AmigaPCI/AmigaPCI-LBC040/KiCAD/AmigaPCI-LBC040-REV60/AmigaPCI-Footprints/PCIe-x16.step

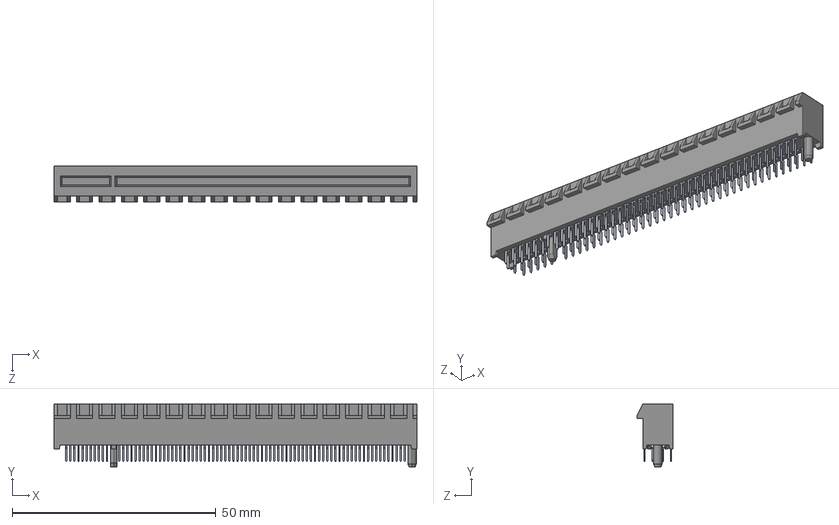
[picture p1: CAD file, 2026-06-23]
KiCAD/AmigaPCI-LBC040-REV60/AmigaPCI-Footprints/PCIe-x16.step
89.0 x 15.4 x 8.80 mm
