AmigaPCI/AmigaPCI-LBC040/KiCAD/AmigaPCI-LBC040-REV60/AmigaPCI-Footprints/DIN150_MALE.STEP

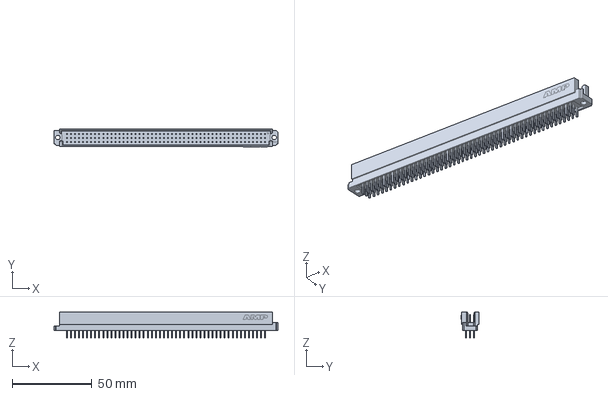
[picture p2: CAD file, 2026-06-23]
KiCAD/AmigaPCI-LBC040-REV60/AmigaPCI-Footprints/DIN150_MALE.STEP
140.6 x 11.0 x 16.1 mm
