AmigaPCI/AmigaPCI-LBC040/KiCAD/AmigaPCI-LBC040-REV60/AmigaPCI-Footprints/5145154-4.step

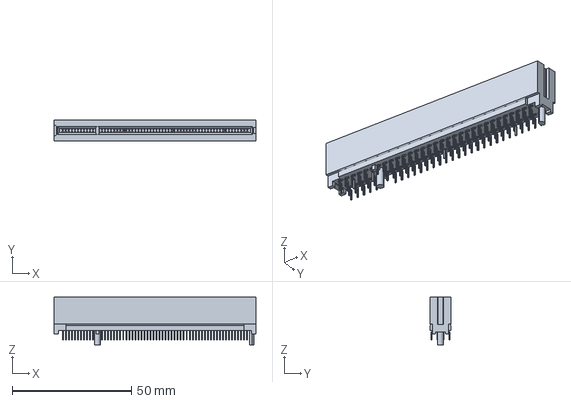
[picture p3: CAD file, 2026-06-23]
KiCAD/AmigaPCI-LBC040-REV60/AmigaPCI-Footprints/5145154-4.step
84.8 x 8.89 x 20.1 mm
