AmigaPCI/AmigaPCI-LBC040/KiCAD/AmigaPCI-LBC040-REV60/AmigaPCI-Footprints/5650910-5.stp

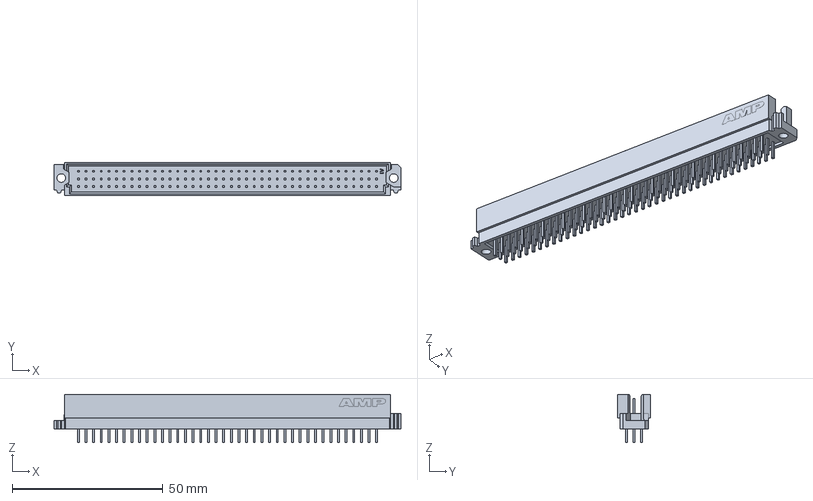
[picture p4: CAD file, 2026-06-23]
KiCAD/AmigaPCI-LBC040-REV60/AmigaPCI-Footprints/5650910-5.stp
115.2 x 11.0 x 16.1 mm
