AmigaPCI/AmigaPCI-LBC040/Schematic/AmigaPCI 68040 Local Bus Card REV60.pdf

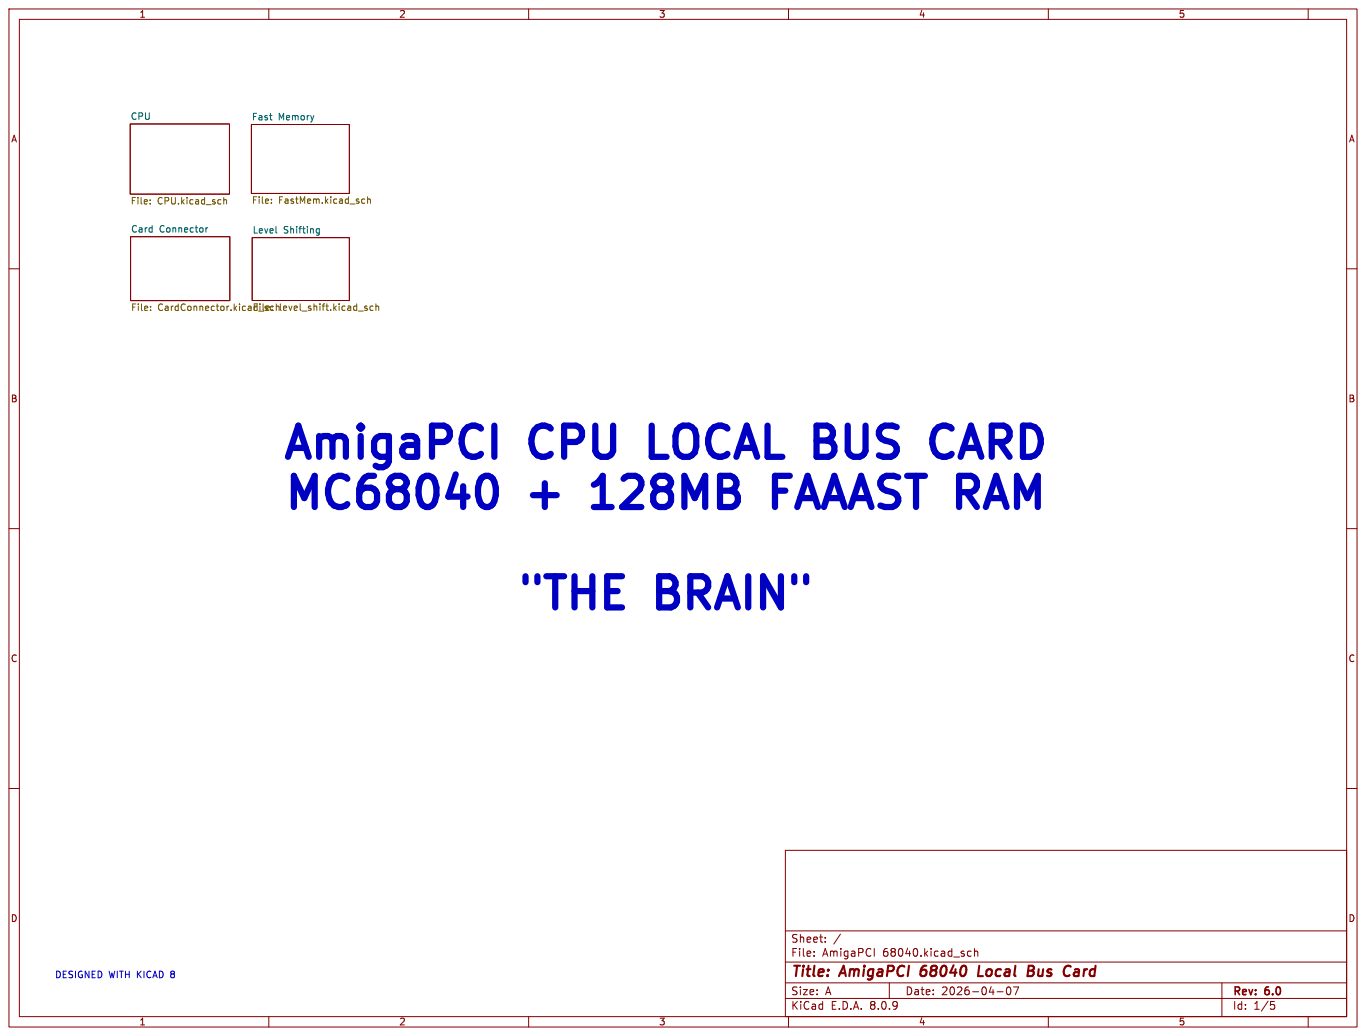
[picture p5: page 1]

Id: 1/5 Title: AmigaPCI 68040 Local Bus Card

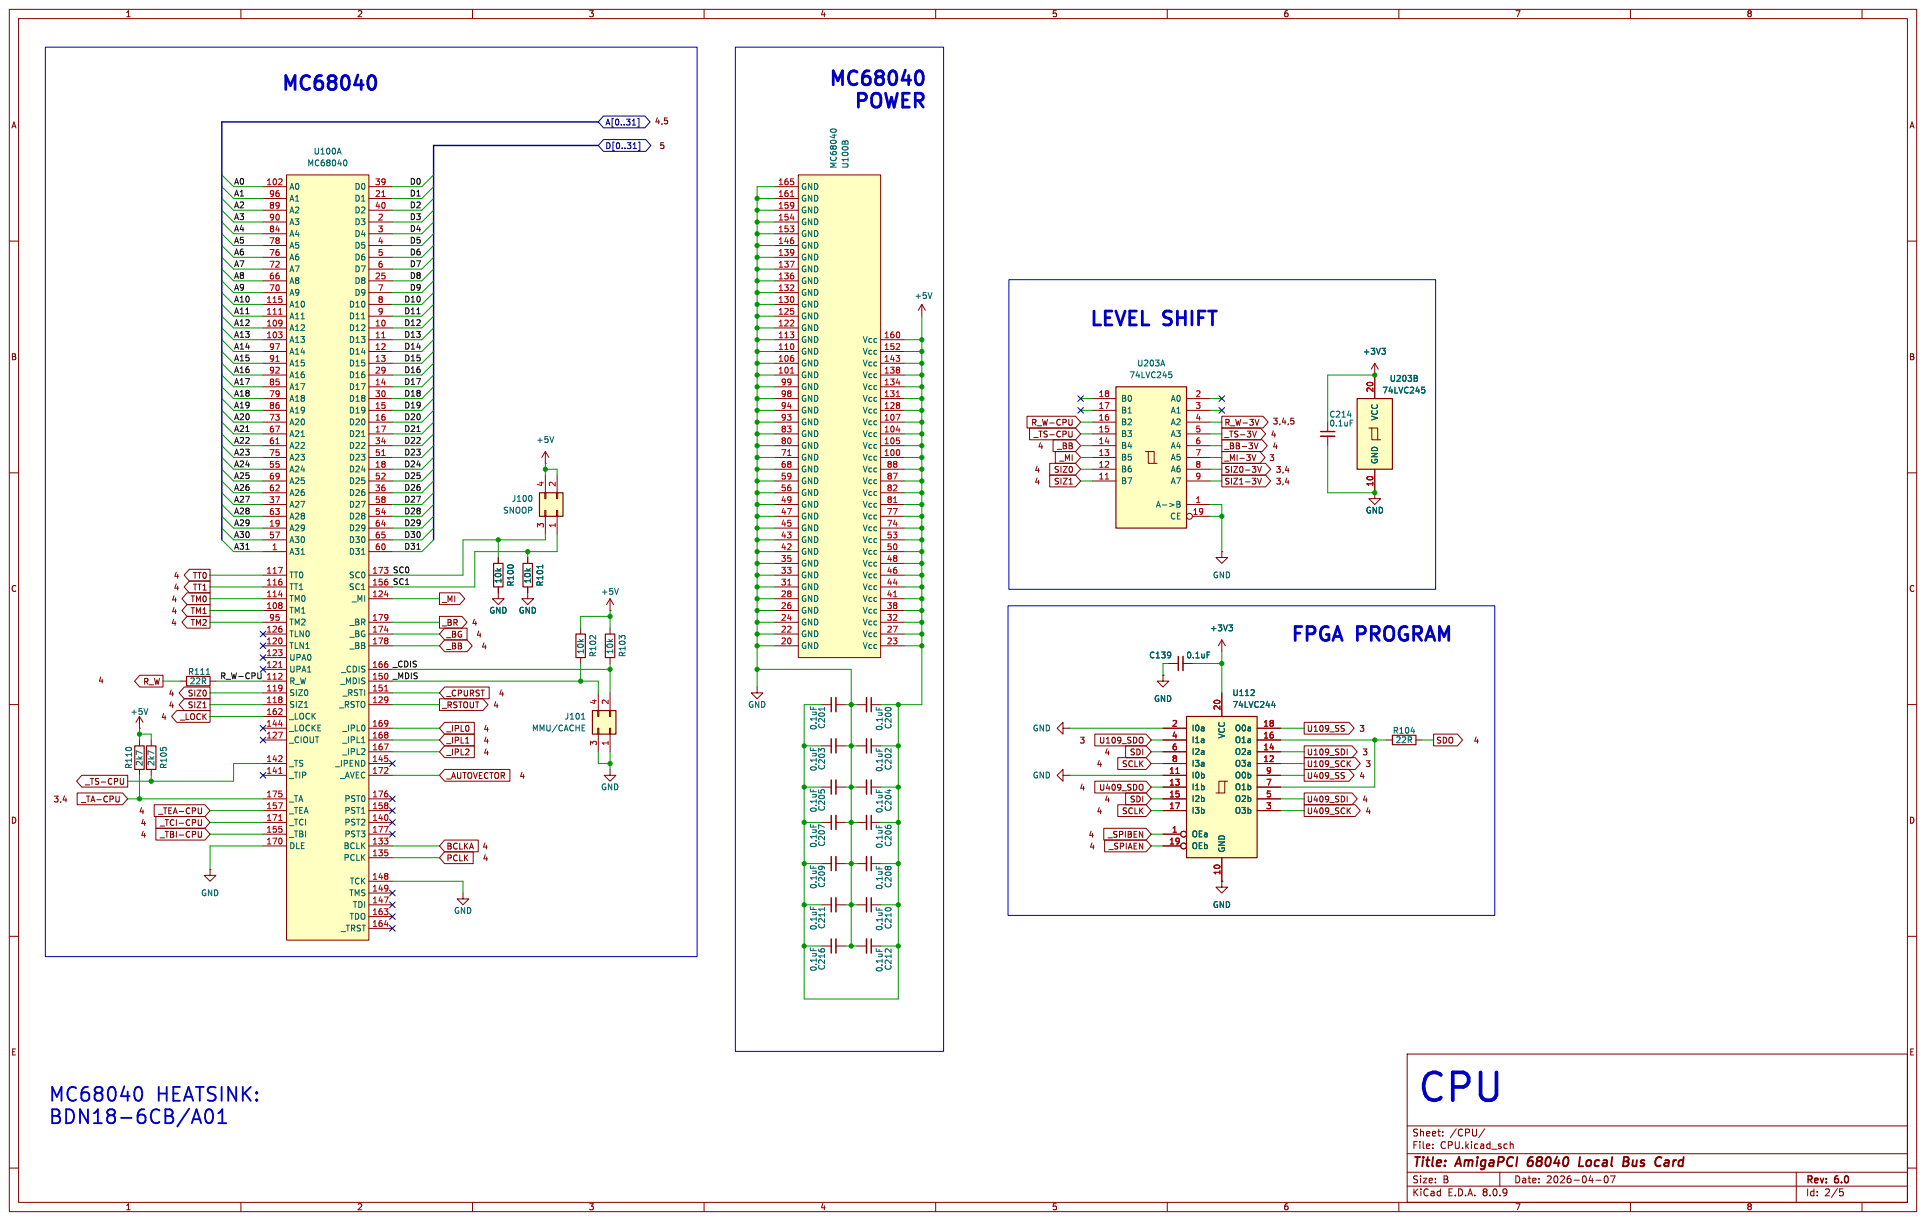
[picture p6: page 2]

74LVC245 GND 10 VCC 20 +3V3 GND GND

Id: 2/5 Title: AmigaPCI 68040 Local Bus Card

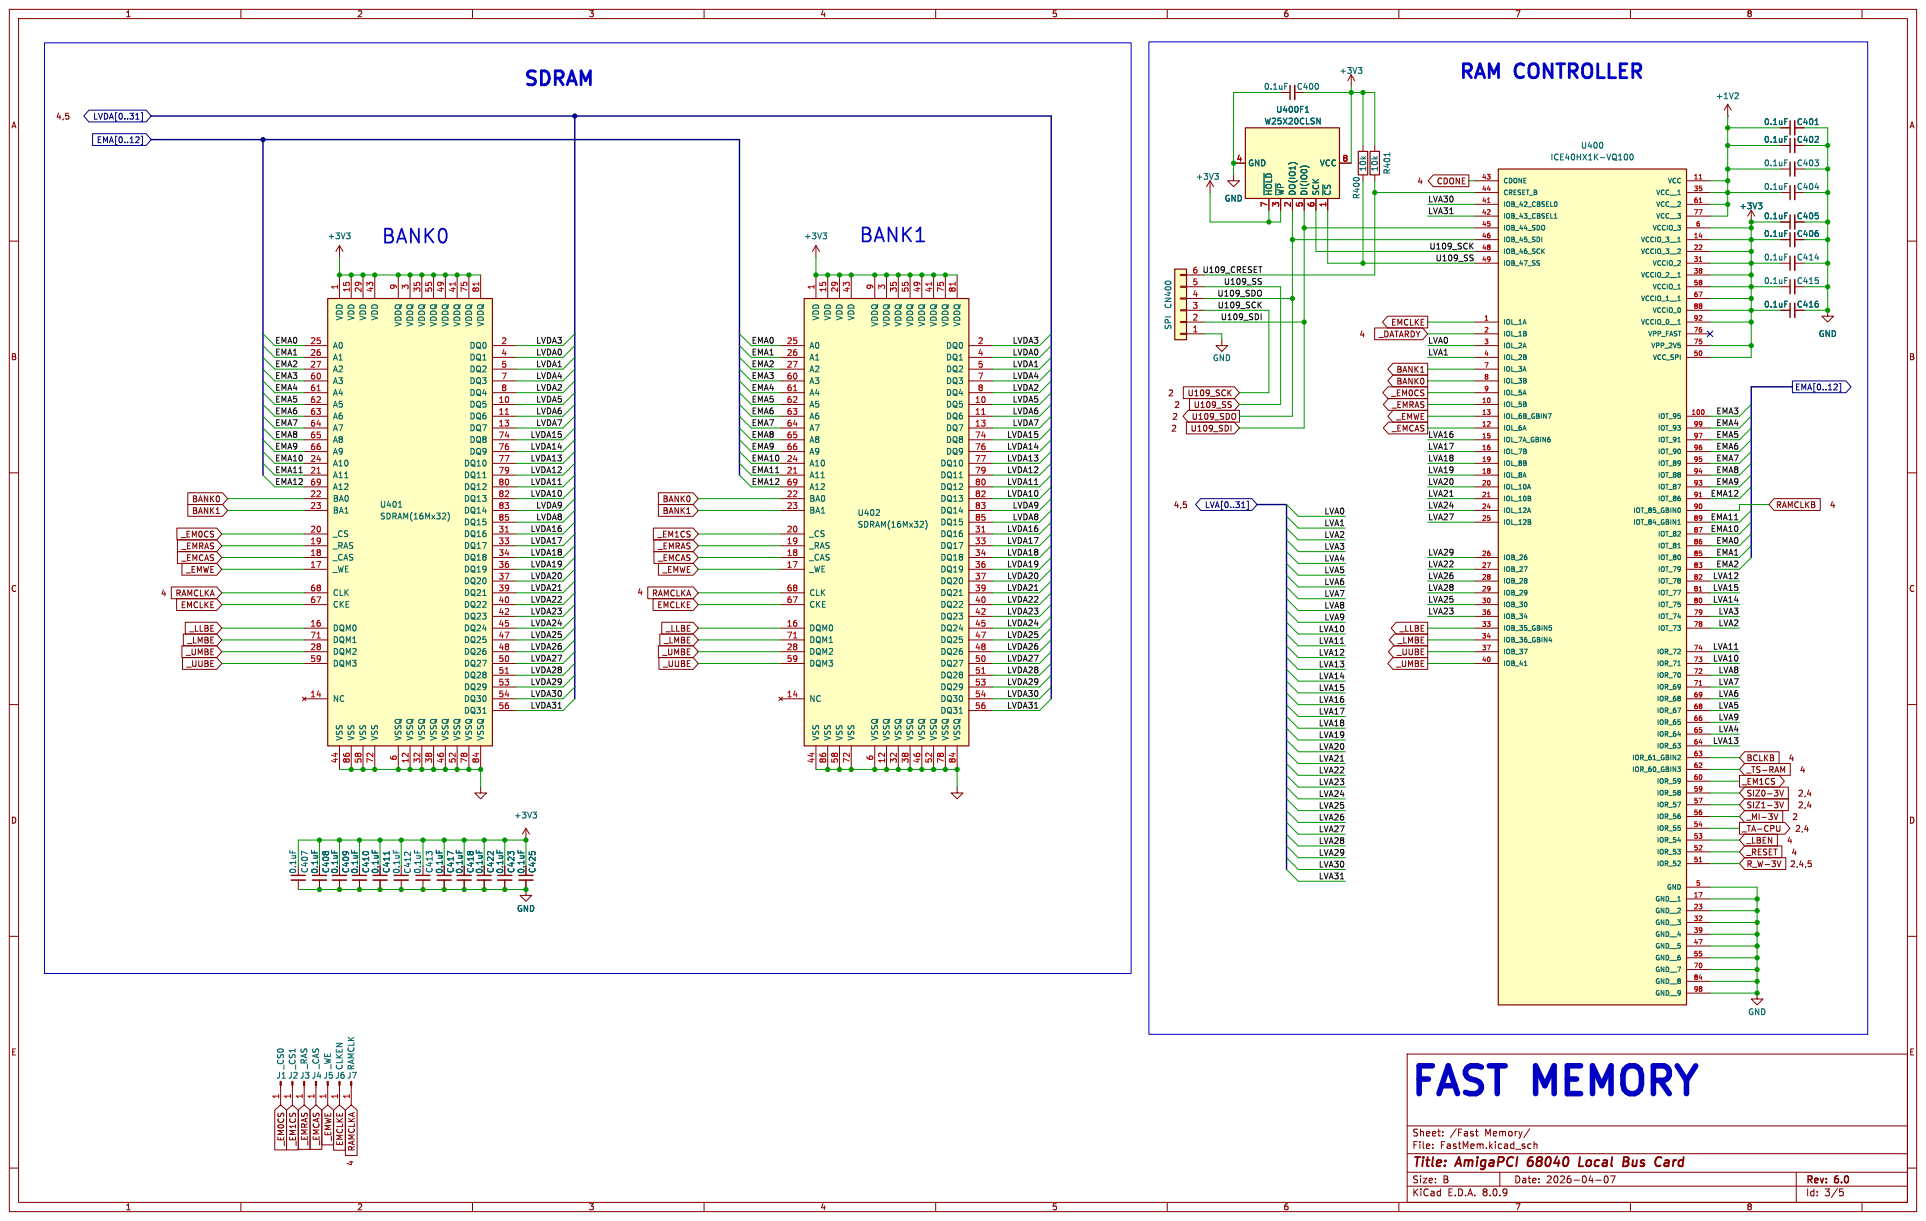
[picture p7: page 3]

Id: 3/5 Title: AmigaPCI 68040 Local Bus Card

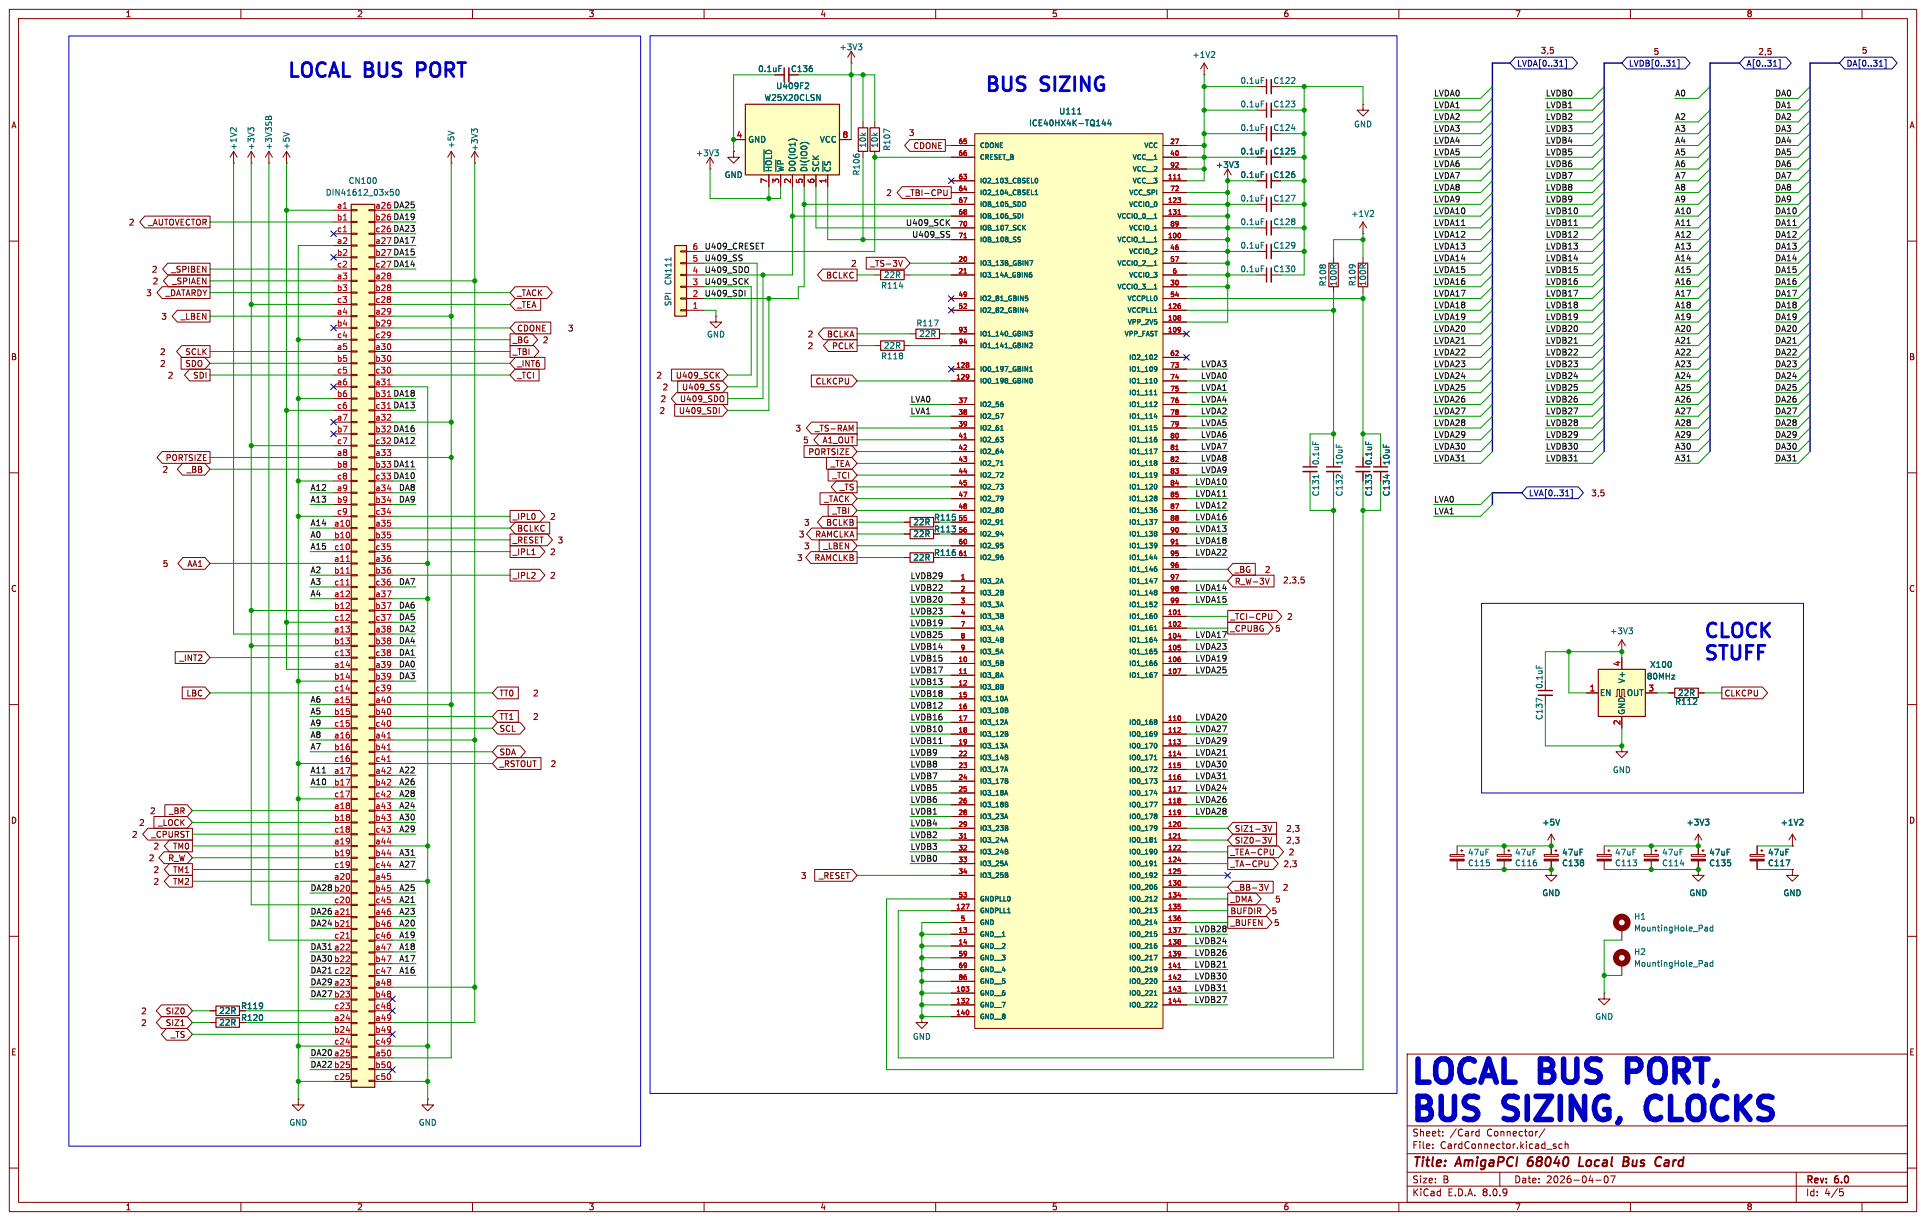
[picture p8: page 4]

Id: 4/5 Title: AmigaPCI 68040 Local Bus Card

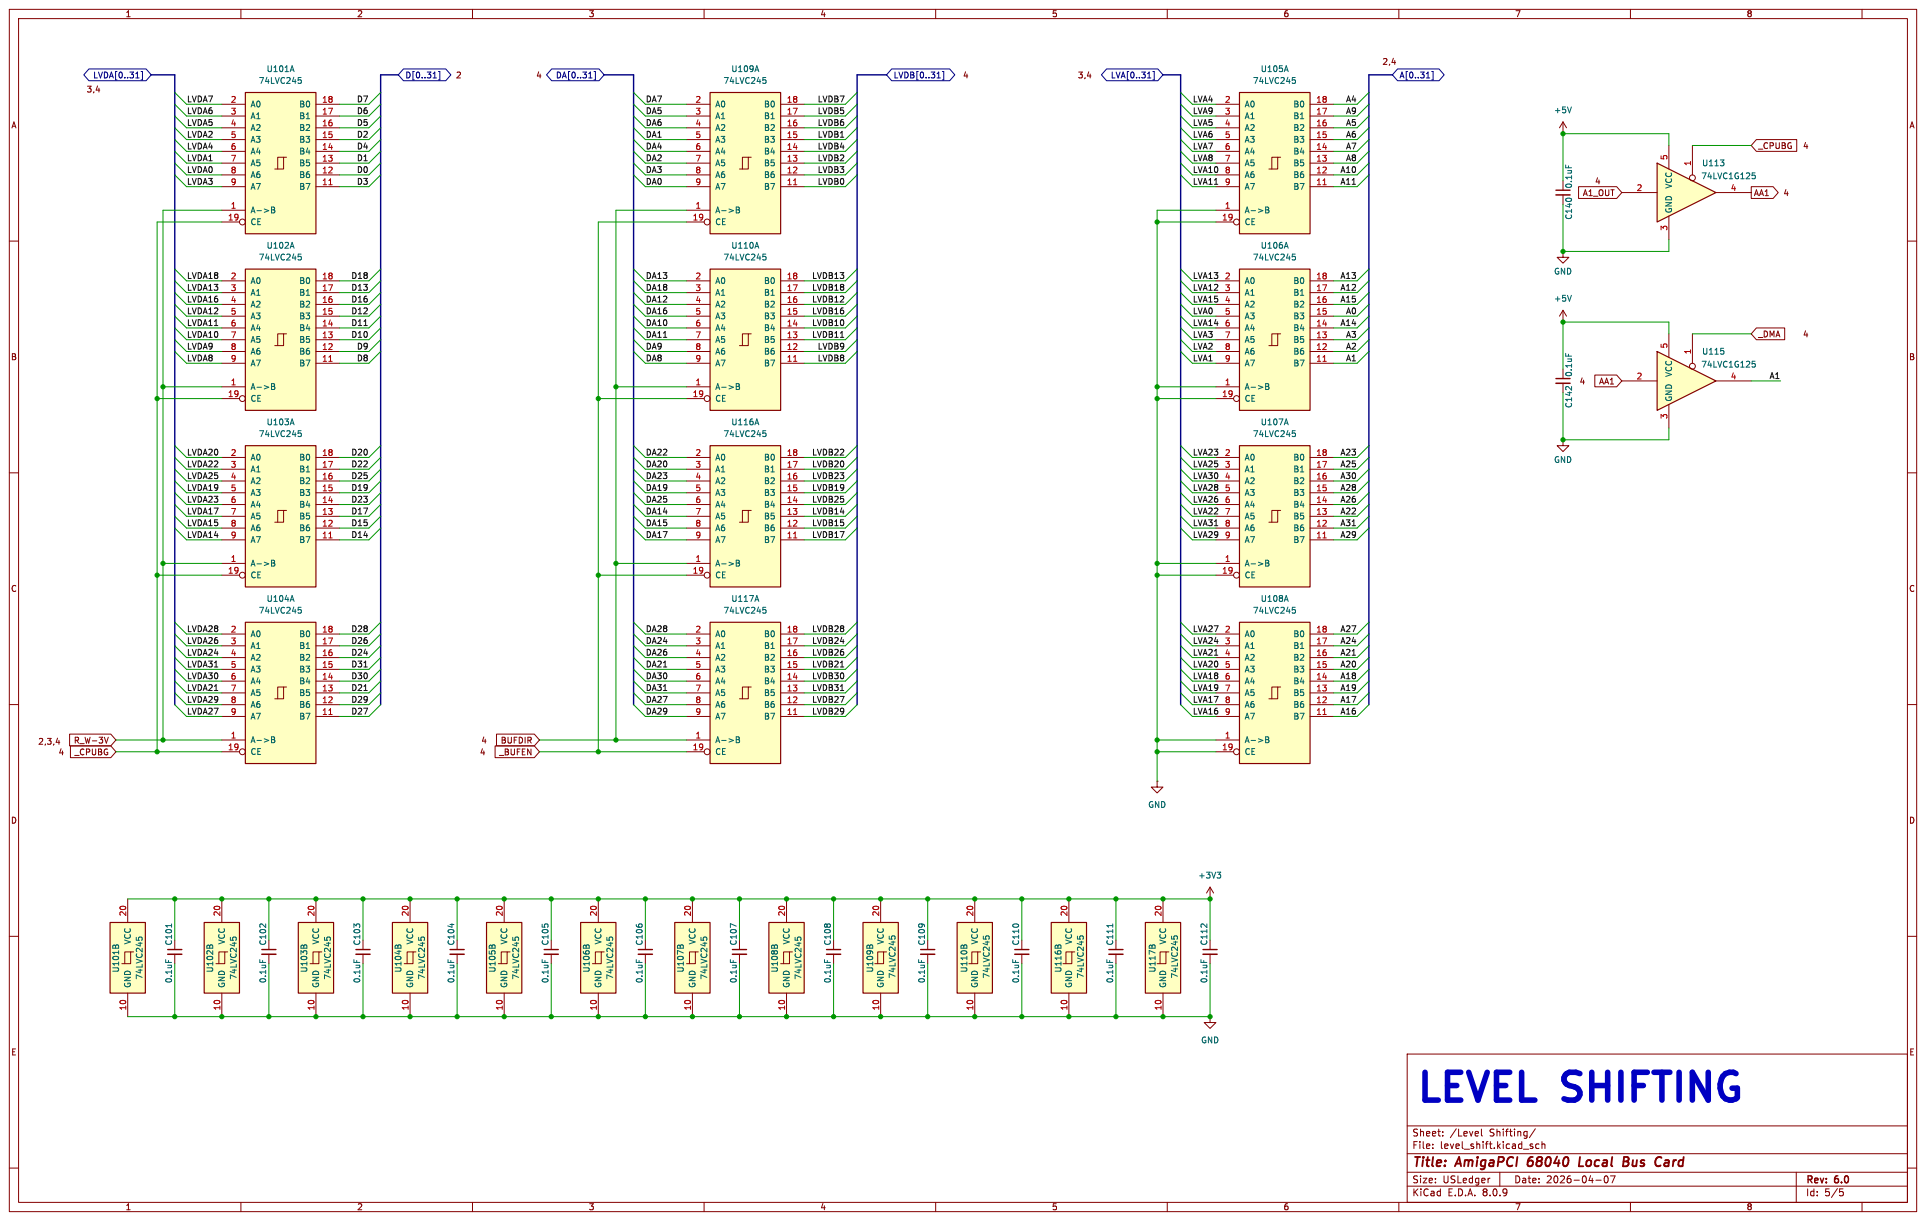
[picture p9: page 5]

Id: 5/5 Title: AmigaPCI 68040 Local Bus Card
