AmigaPCI/AmigaPCI-LBC040/KiCAD/AmigaPCI-LBC040-REV60/AmigaPCI 68040.kicad_pcb

## KiCad design KiCAD/AmigaPCI-LBC040-REV60/AmigaPCI 68040.kicad_pcb (2026-06-23)

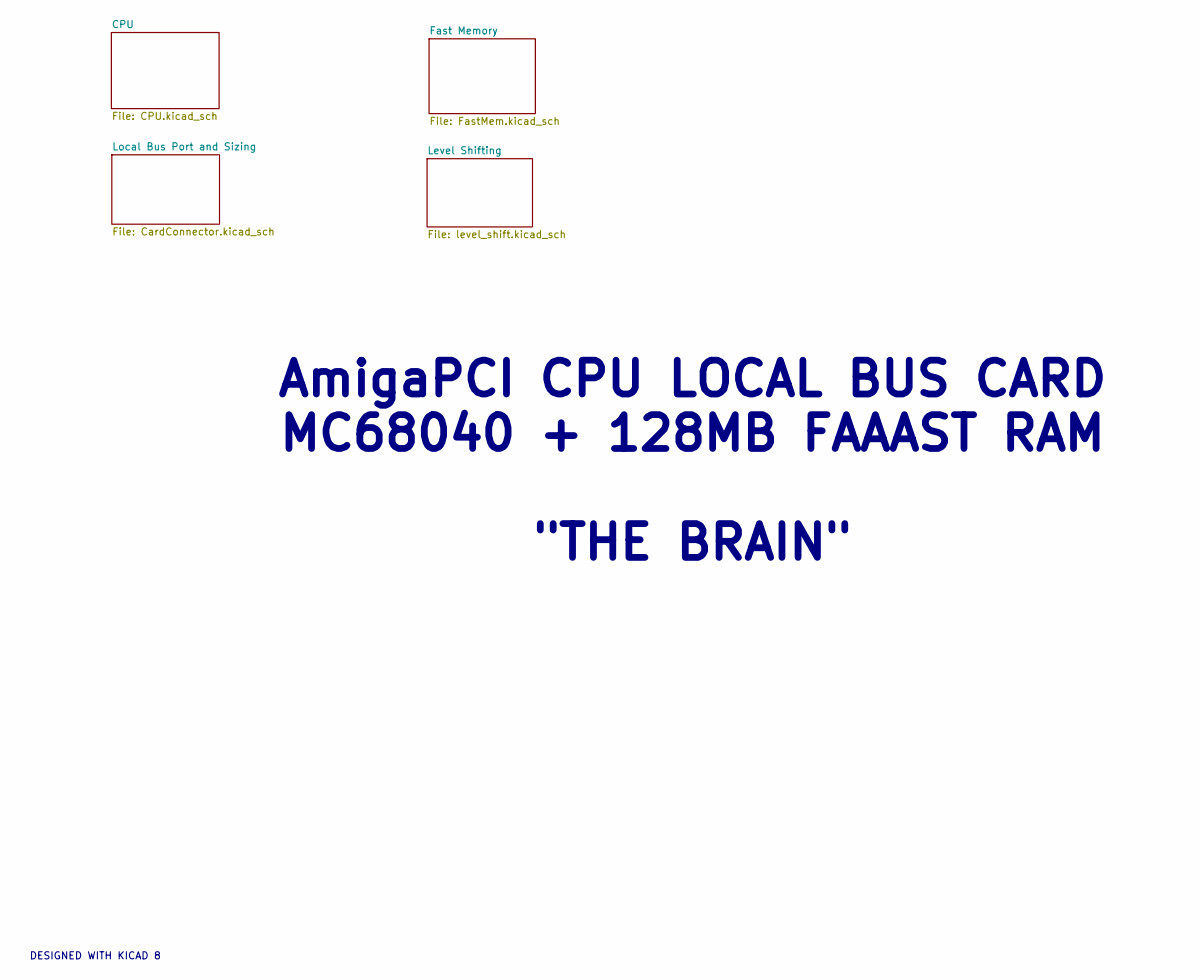
[picture p10: schematic AmigaPCI 68040.kicad_sch, AmigaPCI 68040 Local Bus Card]

Notes on the sheet:
DESIGNED WITH KICAD 8
AmigaPCI CPU LOCAL BUS CARD MC68040 + 128MB FAAAST RAM "THE BRAIN"

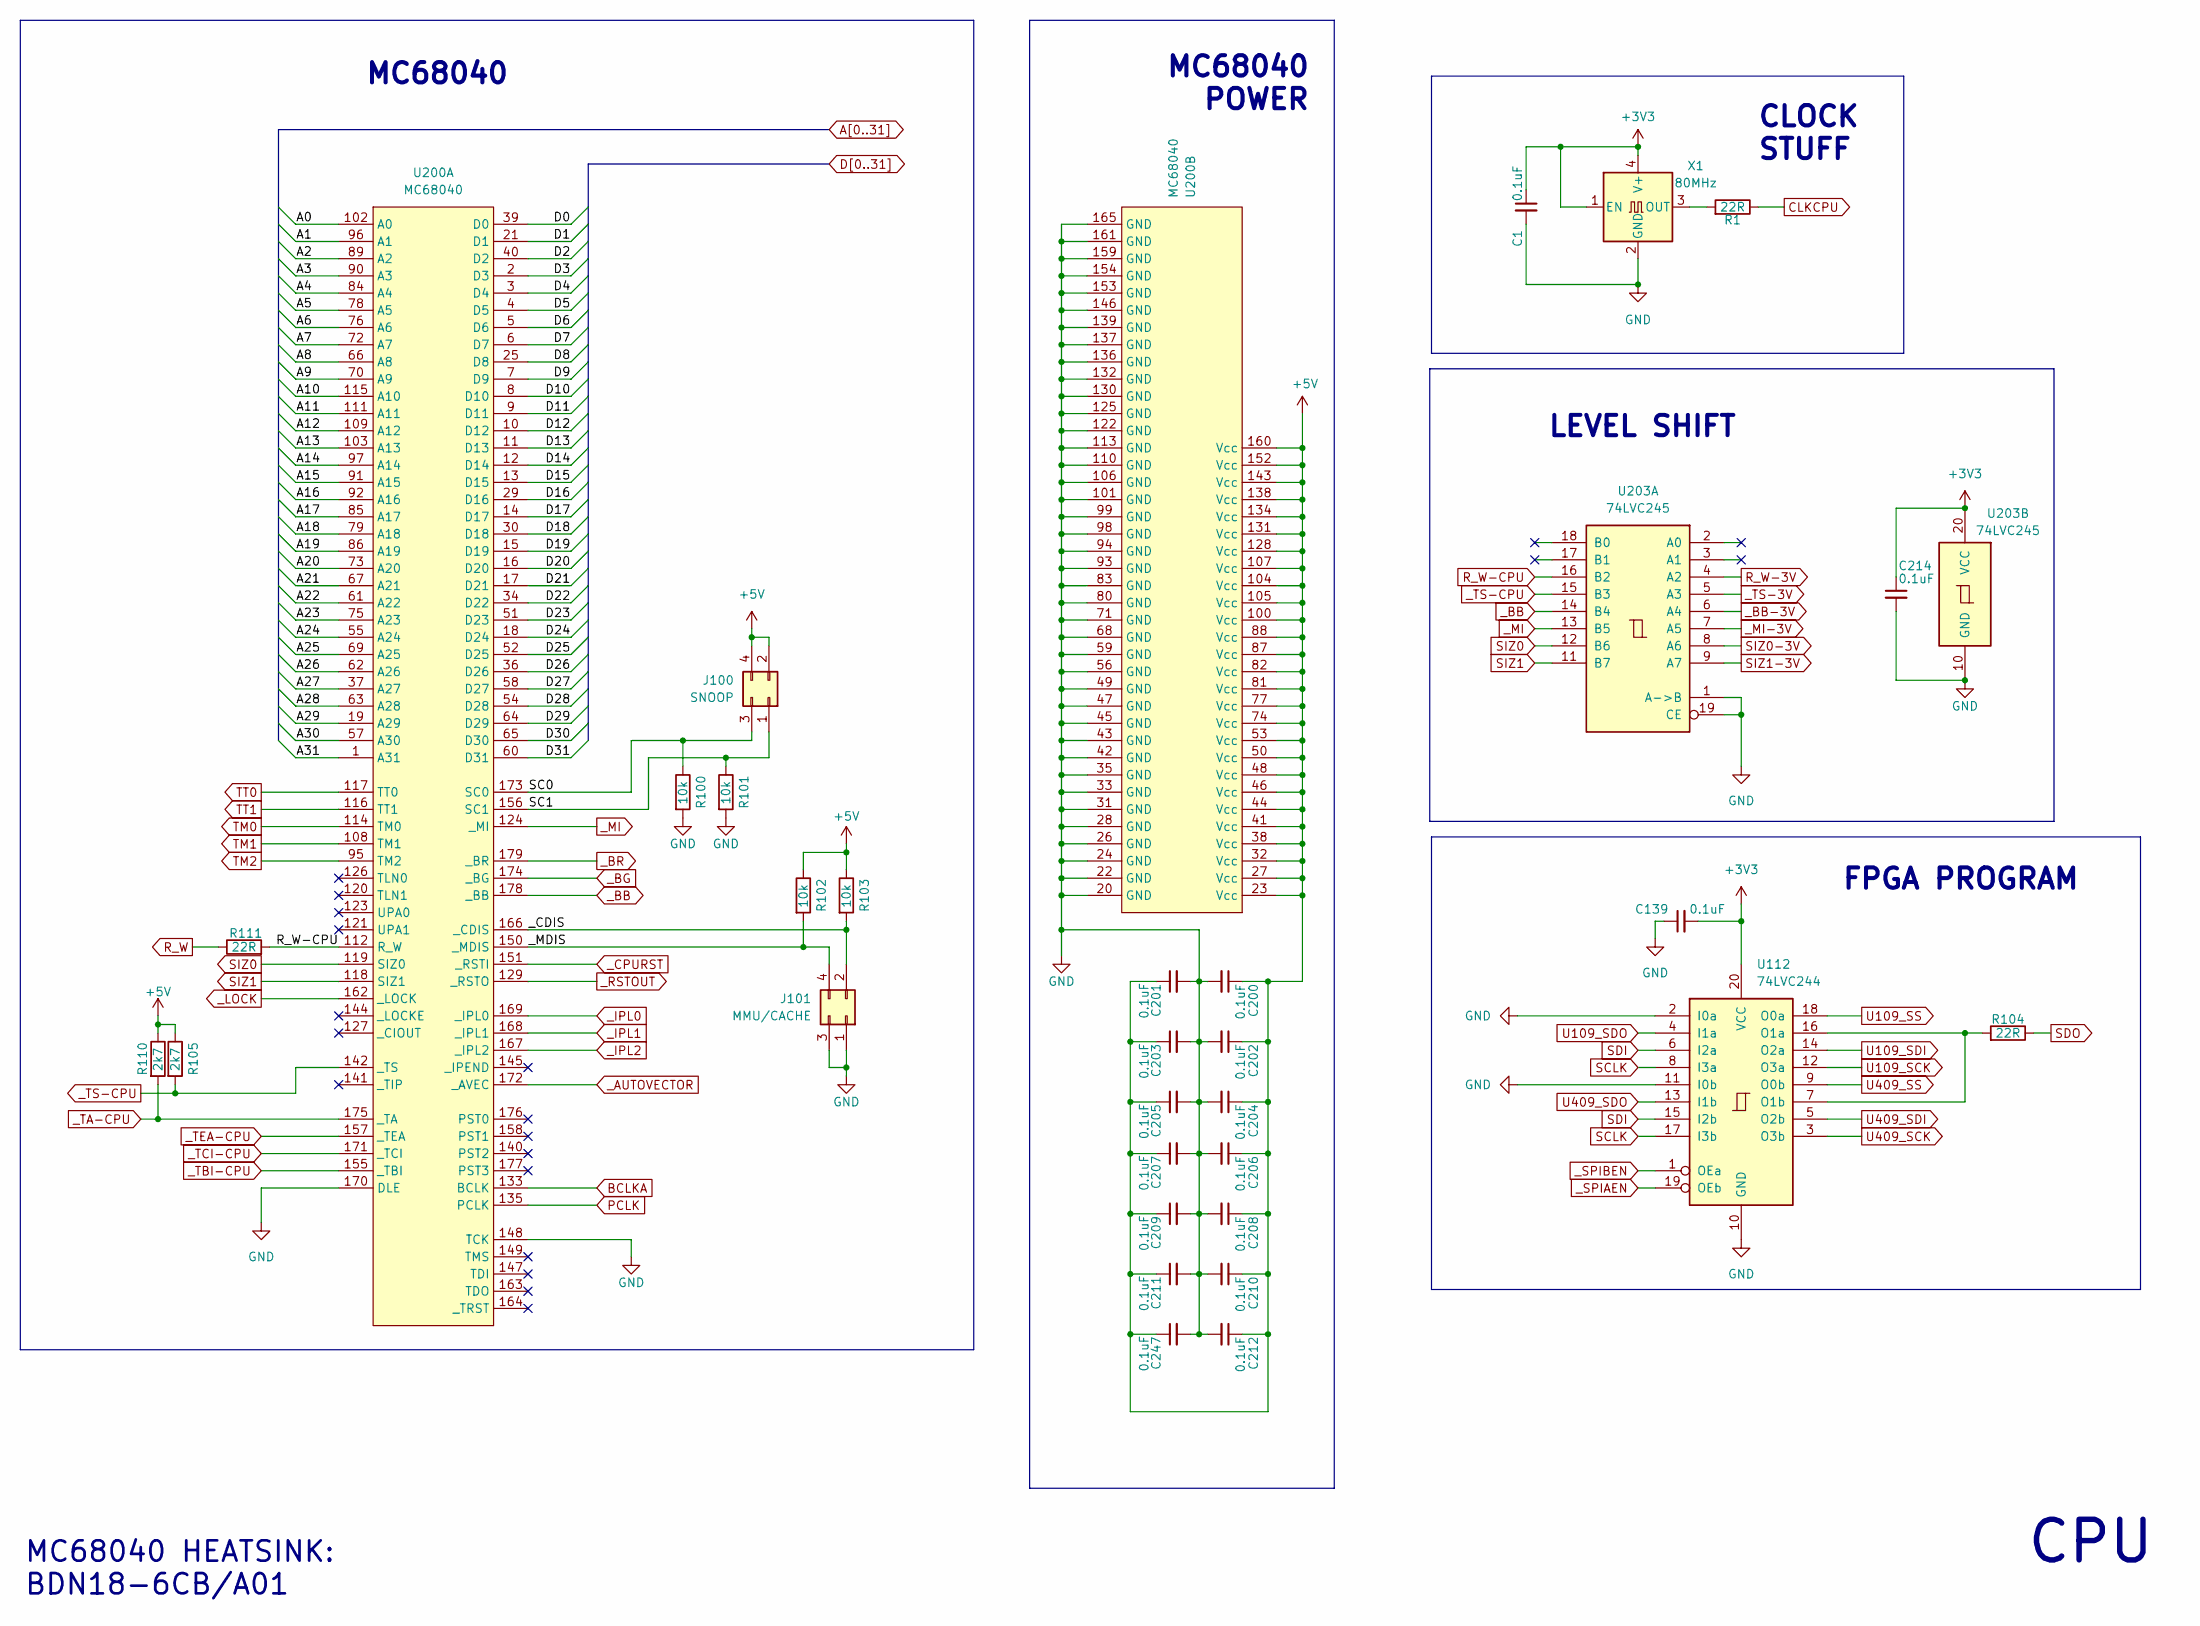
[picture p11: schematic CPU.kicad_sch, AmigaPCI 68040 Local Bus Card]

Parts:
C1, C139, C200, C201, C202, C203, C204, C205, C206, C207, C208, C209, C210, C211, C212, C214, C247: 0.1uF; C_0603_1608Metric; LCSC C14663
J100: SNOOP; PinHeader_2x02_P2.54mm_Vertical; LCSC C66690
J101: MMU/CACHE; PinHeader_2x02_P2.54mm_Vertical; LCSC C66690
R1, R104, R111: 22R; R_0603_1608Metric; LCSC C23345
R100, R101, R102, R103: 10k; R_0603_1608Metric; LCSC C25804
R105, R110: 2k7; R_0603_1608Metric; LCSC C13167
U112: 74LVC244; TSSOP-20_4.4x6.5mm_P0.65mm; LCSC C7668
U200: MC68040; PGA179
U203: 74LVC245; TSSOP-20_4.4x6.5mm_P0.65mm; LCSC C7848
X1: 80MHz; Oscillator_SMD_ECS_2520MV-xxx-xx-4Pin_2.5x2.0mm; LCSC C557215

Connections:
+3V3: C1.1, C139.2, C214.1, U112.20 (VCC), U203.20 (VCC), X1.1 (EN), X1.4 (V+); also elsewhere on the board
+5V: C200.1, C201.1, C202.1, C203.1, C204.1, C205.1, C206.1, C207.1, C208.1, C209.1, C210.1, C211.1, C212.1, J100.2, J100.4, R102.1, R103.1, R105.1, R110.1; also elsewhere on the board
/CPU/SC0: J100.3, R100.1; also elsewhere on the board
/CPU/SC1: J100.1, R101.1; also elsewhere on the board
/CPU/_CDIS: J101.2, R103.2; also elsewhere on the board
/CPU/_MDIS: J101.4, R102.2; also elsewhere on the board
GND: C1.2, C139.1, C200.2, C201.2, C202.2, C203.2, C204.2, C205.2, C206.2, C207.2, C208.2, C209.2, C210.2, C211.2, C212.2, C214.2, J101.1, J101.3, R100.2, R101.2, U112.2 (I0a), U112.10 (GND), U112.11 (I0b), U203.1 (A->B), U203.10 (GND), U203.19 (CE), X1.2 (GND); also elsewhere on the board
unnamed: R1.2, X1.3 (OUT)
unnamed: R104.2, U112.7 (O1b), U112.16 (O1a)
R_W: R111.1; also elsewhere on the board
R_W-3V: U203.4 (A2); also elsewhere on the board
R_W-CPU: R111.2, U203.16 (B2); also elsewhere on the board
SCLK: U112.8 (I3a), U112.17 (I3b); also elsewhere on the board
SDI: U112.6 (I2a), U112.15 (I2b); also elsewhere on the board
SDO: R104.1; also elsewhere on the board
SIZ0: U203.12 (B6); also elsewhere on the board
SIZ0-3V: U203.8 (A6); also elsewhere on the board
SIZ1: U203.11 (B7); also elsewhere on the board
SIZ1-3V: U203.9 (A7); also elsewhere on the board
U109_SCK: U112.12 (O3a); also elsewhere on the board
U109_SDI: U112.14 (O2a); also elsewhere on the board
U109_SDO: U112.4 (I1a); also elsewhere on the board
U109_SS: U112.18 (O0a); also elsewhere on the board
U409_SCK: U112.3 (O3b); also elsewhere on the board
U409_SDI: U112.5 (O2b); also elsewhere on the board
U409_SDO: U112.13 (I1b); also elsewhere on the board
U409_SS: U112.9 (O0b); also elsewhere on the board
_BB: U203.14 (B4); also elsewhere on the board
_BB-3V: U203.6 (A4); also elsewhere on the board
_MI: U203.13 (B5); also elsewhere on the board
_MI-3V: U203.7 (A5); also elsewhere on the board
_SPIAEN: U112.19 (OEb); also elsewhere on the board
_SPIBEN: U112.1 (OEa); also elsewhere on the board
_TA-CPU: R110.2; also elsewhere on the board
_TS-3V: U203.5 (A3); also elsewhere on the board
_TS-CPU: R105.2, U203.15 (B3); also elsewhere on the board

Notes on the sheet:
FPGA PROGRAM
MC68040 HEATSINK: BDN18-6CB/A01
LEVEL SHIFT
MC68040
CLOCK STUFF
MC68040 POWER
CPU

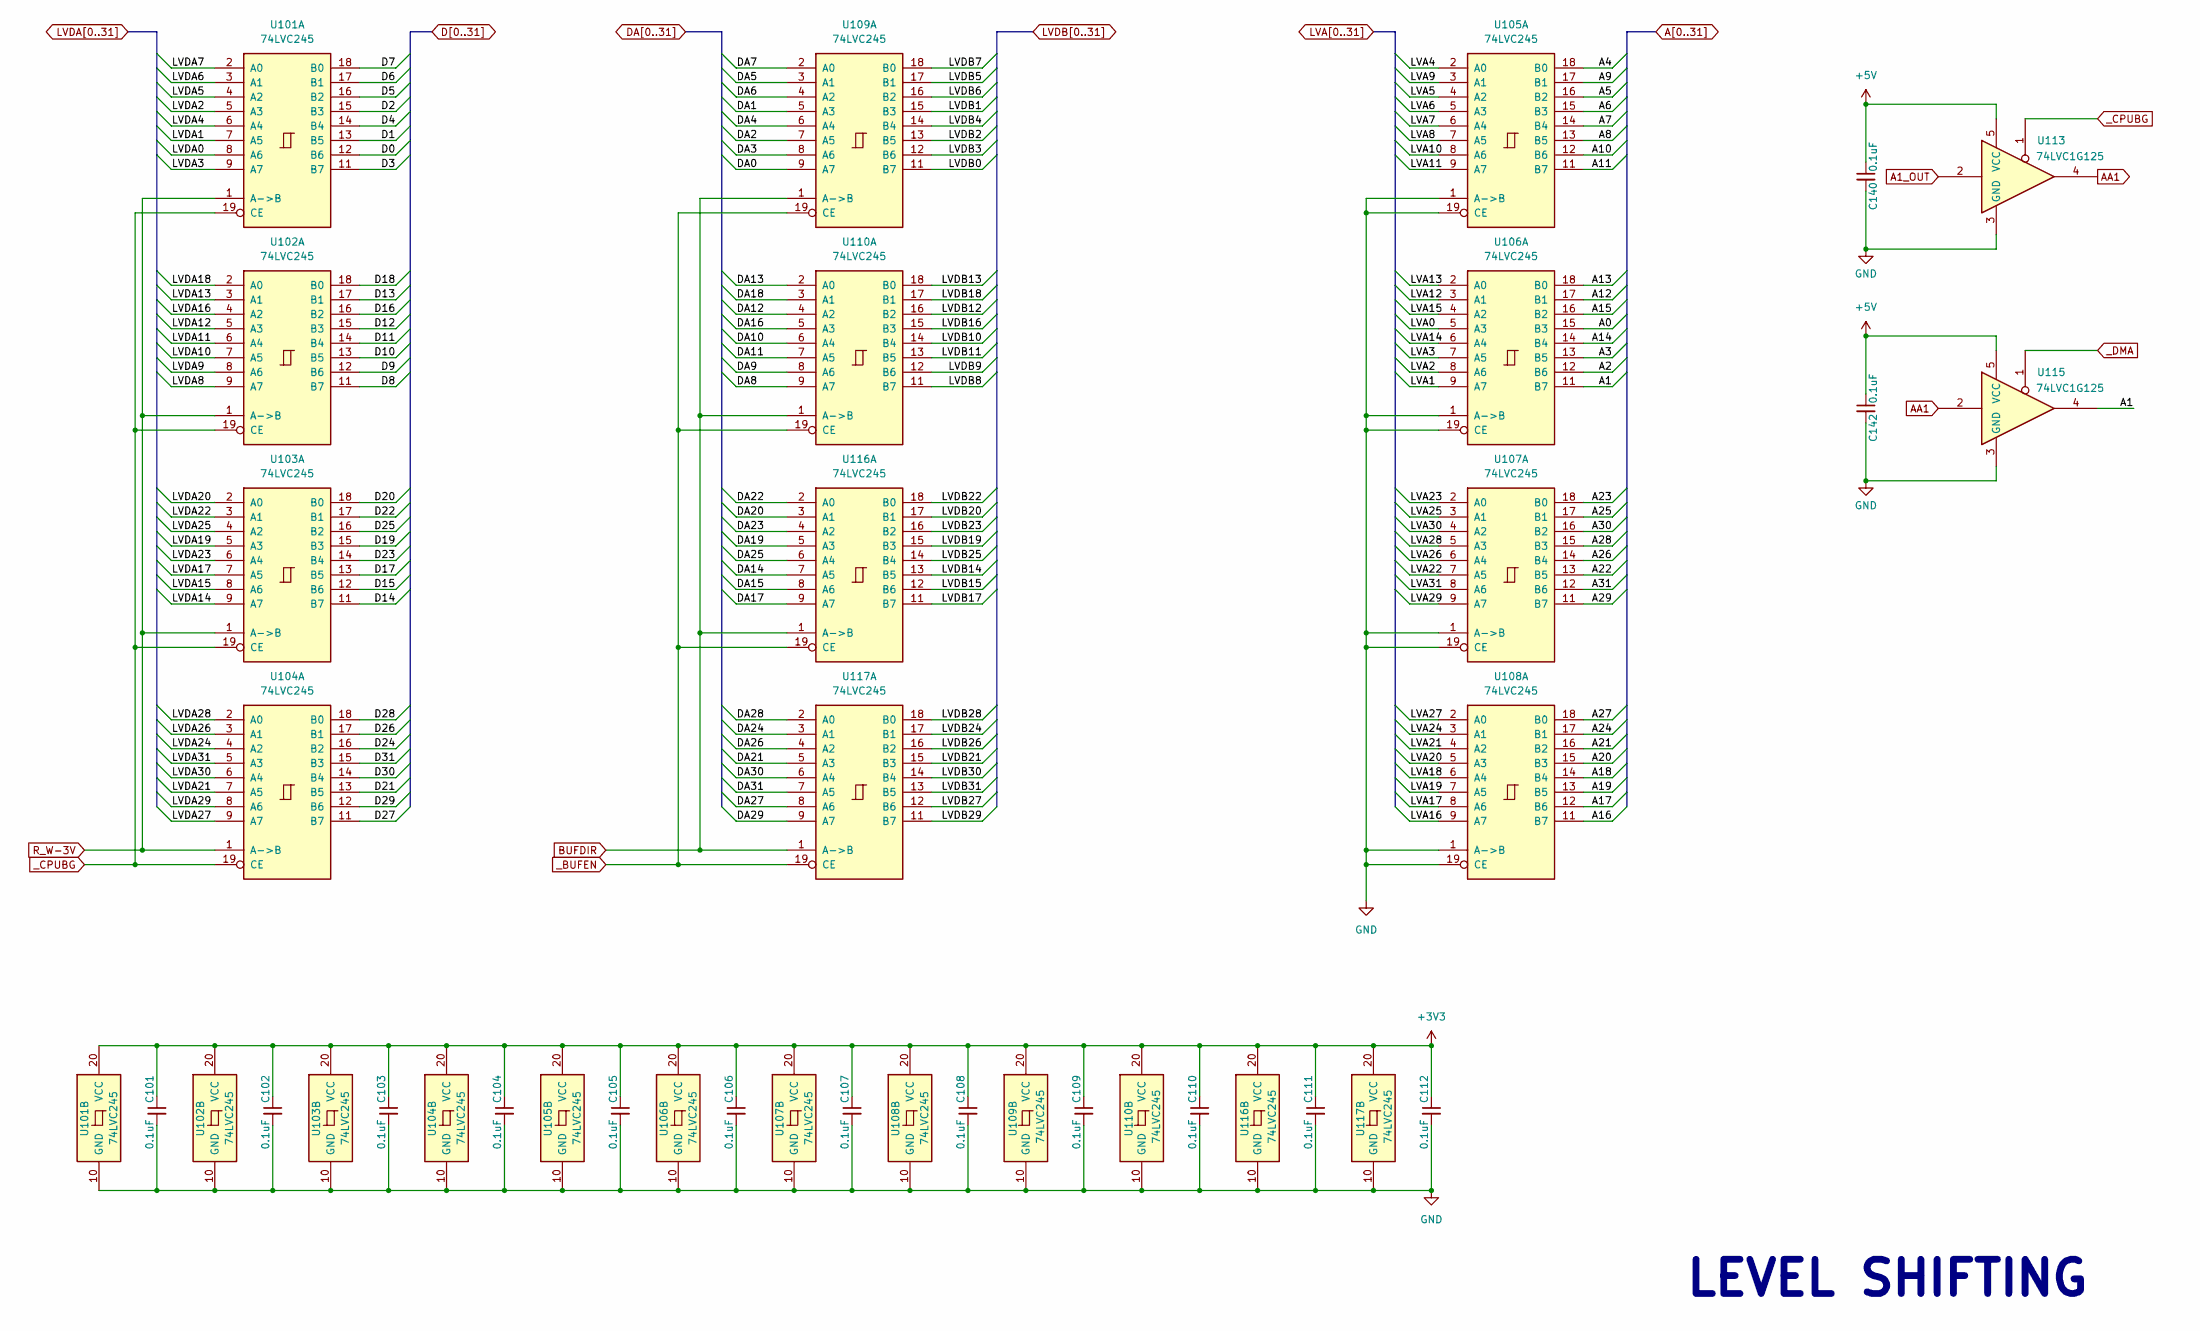
[picture p12: schematic level_shift.kicad_sch, AmigaPCI 68040 Local Bus Card]

Parts:
C101, C102, C103, C104, C105, C106, C107, C108, C109, C110, C111, C112, C140, C142: 0.1uF; C_0603_1608Metric; LCSC C14663
U101, U102, U103, U104, U105, U106, U107, U108, U109, U110, U116, U117: 74LVC245; TSSOP-20_4.4x6.5mm_P0.65mm; LCSC C7848
U113, U115: 74LVC1G125; SOT-353_SC-70-5; PartNum SN74LVC1G125DBVR; LCSC C151022

Connections:
+3V3: C101.1, C102.1, C103.1, C104.1, C105.1, C106.1, C107.1, C108.1, C109.1, C110.1, C111.1, C112.1, U101.20 (VCC), U102.20 (VCC), U103.20 (VCC), U104.20 (VCC), U105.20 (VCC), U106.20 (VCC), U107.20 (VCC), U108.20 (VCC), U109.20 (VCC), U110.20 (VCC), U116.20 (VCC), U117.20 (VCC); also elsewhere on the board
+5V: C140.1, C142.1, U113.5 (VCC), U115.5 (VCC); also elsewhere on the board
A0: U106.15 (B3); also elsewhere on the board
A1: U106.11 (B7), U115.4; also elsewhere on the board
A1_OUT: U113.2; also elsewhere on the board
A2: U106.12 (B6); also elsewhere on the board
A3: U106.13 (B5); also elsewhere on the board
A4: U105.18 (B0); also elsewhere on the board
A5: U105.16 (B2); also elsewhere on the board
A6: U105.15 (B3); also elsewhere on the board
A7: U105.14 (B4); also elsewhere on the board
A8: U105.13 (B5); also elsewhere on the board
A9: U105.17 (B1); also elsewhere on the board
A10: U105.12 (B6); also elsewhere on the board
A11: U105.11 (B7); also elsewhere on the board
A12: U106.17 (B1); also elsewhere on the board
A13: U106.18 (B0); also elsewhere on the board
A14: U106.14 (B4); also elsewhere on the board
A15: U106.16 (B2); also elsewhere on the board
A16: U108.11 (B7); also elsewhere on the board
A17: U108.12 (B6); also elsewhere on the board
A18: U108.14 (B4); also elsewhere on the board
A19: U108.13 (B5); also elsewhere on the board
A20: U108.15 (B3); also elsewhere on the board
A21: U108.16 (B2); also elsewhere on the board
A22: U107.13 (B5); also elsewhere on the board
A23: U107.18 (B0); also elsewhere on the board
A24: U108.17 (B1); also elsewhere on the board
A25: U107.17 (B1); also elsewhere on the board
A26: U107.14 (B4); also elsewhere on the board
A27: U108.18 (B0); also elsewhere on the board
A28: U107.15 (B3); also elsewhere on the board
A29: U107.11 (B7); also elsewhere on the board
A30: U107.16 (B2); also elsewhere on the board
A31: U107.12 (B6); also elsewhere on the board
AA1: U113.4, U115.2; also elsewhere on the board
BUFDIR: U109.1 (A->B), U110.1 (A->B), U116.1 (A->B), U117.1 (A->B); also elsewhere on the board
D0: U101.12 (B6); also elsewhere on the board
D1: U101.13 (B5); also elsewhere on the board
D2: U101.15 (B3); also elsewhere on the board
D3: U101.11 (B7); also elsewhere on the board
D4: U101.14 (B4); also elsewhere on the board
D5: U101.16 (B2); also elsewhere on the board
D6: U101.17 (B1); also elsewhere on the board
D7: U101.18 (B0); also elsewhere on the board
D8: U102.11 (B7); also elsewhere on the board
D9: U102.12 (B6); also elsewhere on the board
D10: U102.13 (B5); also elsewhere on the board
D11: U102.14 (B4); also elsewhere on the board
D12: U102.15 (B3); also elsewhere on the board
D13: U102.17 (B1); also elsewhere on the board
D14: U103.11 (B7); also elsewhere on the board
D15: U103.12 (B6); also elsewhere on the board
D16: U102.16 (B2); also elsewhere on the board
D17: U103.13 (B5); also elsewhere on the board
D18: U102.18 (B0); also elsewhere on the board
D19: U103.15 (B3); also elsewhere on the board
D20: U103.18 (B0); also elsewhere on the board
D21: U104.13 (B5); also elsewhere on the board
D22: U103.17 (B1); also elsewhere on the board
D23: U103.14 (B4); also elsewhere on the board
D24: U104.16 (B2); also elsewhere on the board
D25: U103.16 (B2); also elsewhere on the board
D26: U104.17 (B1); also elsewhere on the board
D27: U104.11 (B7); also elsewhere on the board
D28: U104.18 (B0); also elsewhere on the board
D29: U104.12 (B6); also elsewhere on the board
D30: U104.14 (B4); also elsewhere on the board
D31: U104.15 (B3); also elsewhere on the board
DA0: U109.9 (A7); also elsewhere on the board
DA1: U109.5 (A3); also elsewhere on the board
DA2: U109.7 (A5); also elsewhere on the board
DA3: U109.8 (A6); also elsewhere on the board
DA4: U109.6 (A4); also elsewhere on the board
DA5: U109.3 (A1); also elsewhere on the board
DA6: U109.4 (A2); also elsewhere on the board
DA7: U109.2 (A0); also elsewhere on the board
DA8: U110.9 (A7); also elsewhere on the board
DA9: U110.8 (A6); also elsewhere on the board
DA10: U110.6 (A4); also elsewhere on the board
DA11: U110.7 (A5); also elsewhere on the board
DA12: U110.4 (A2); also elsewhere on the board
DA13: U110.2 (A0); also elsewhere on the board
DA14: U116.7 (A5); also elsewhere on the board
DA15: U116.8 (A6); also elsewhere on the board
DA16: U110.5 (A3); also elsewhere on the board
DA17: U116.9 (A7); also elsewhere on the board
DA18: U110.3 (A1); also elsewhere on the board
DA19: U116.5 (A3); also elsewhere on the board
DA20: U116.3 (A1); also elsewhere on the board
DA21: U117.5 (A3); also elsewhere on the board
DA22: U116.2 (A0); also elsewhere on the board
DA23: U116.4 (A2); also elsewhere on the board
DA24: U117.3 (A1); also elsewhere on the board
DA25: U116.6 (A4); also elsewhere on the board
DA26: U117.4 (A2); also elsewhere on the board
DA27: U117.8 (A6); also elsewhere on the board
DA28: U117.2 (A0); also elsewhere on the board
DA29: U117.9 (A7); also elsewhere on the board
DA30: U117.6 (A4); also elsewhere on the board
DA31: U117.7 (A5); also elsewhere on the board
GND: C101.2, C102.2, C103.2, C104.2, C105.2, C106.2, C107.2, C108.2, C109.2, C110.2, C111.2, C112.2, C140.2, C142.2, U101.10 (GND), U102.10 (GND), U103.10 (GND), U104.10 (GND), U105.1 (A->B), U105.10 (GND), U105.19 (CE), U106.1 (A->B), U106.10 (GND), U106.19 (CE), U107.1 (A->B), U107.10 (GND), U107.19 (CE), U108.1 (A->B), U108.10 (GND), U108.19 (CE), U109.10 (GND), U110.10 (GND), U113.3 (GND), U115.3 (GND), U116.10 (GND), U117.10 (GND); also elsewhere on the board
LVA0: U106.5 (A3); also elsewhere on the board
LVA1: U106.9 (A7); also elsewhere on the board
LVA2: U106.8 (A6); also elsewhere on the board
LVA3: U106.7 (A5); also elsewhere on the board
LVA4: U105.2 (A0); also elsewhere on the board
LVA5: U105.4 (A2); also elsewhere on the board
LVA6: U105.5 (A3); also elsewhere on the board
LVA7: U105.6 (A4); also elsewhere on the board
LVA8: U105.7 (A5); also elsewhere on the board
LVA9: U105.3 (A1); also elsewhere on the board
LVA10: U105.8 (A6); also elsewhere on the board
LVA11: U105.9 (A7); also elsewhere on the board
LVA12: U106.3 (A1); also elsewhere on the board
LVA13: U106.2 (A0); also elsewhere on the board
LVA14: U106.6 (A4); also elsewhere on the board
LVA15: U106.4 (A2); also elsewhere on the board
LVA16: U108.9 (A7); also elsewhere on the board
LVA17: U108.8 (A6); also elsewhere on the board
LVA18: U108.6 (A4); also elsewhere on the board
LVA19: U108.7 (A5); also elsewhere on the board
LVA20: U108.5 (A3); also elsewhere on the board
LVA21: U108.4 (A2); also elsewhere on the board
LVA22: U107.7 (A5); also elsewhere on the board
LVA23: U107.2 (A0); also elsewhere on the board
LVA24: U108.3 (A1); also elsewhere on the board
LVA25: U107.3 (A1); also elsewhere on the board
LVA26: U107.6 (A4); also elsewhere on the board
LVA27: U108.2 (A0); also elsewhere on the board
LVA28: U107.5 (A3); also elsewhere on the board
LVA29: U107.9 (A7); also elsewhere on the board
LVA30: U107.4 (A2); also elsewhere on the board
LVA31: U107.8 (A6); also elsewhere on the board
LVDA0: U101.8 (A6); also elsewhere on the board
LVDA1: U101.7 (A5); also elsewhere on the board
LVDA2: U101.5 (A3); also elsewhere on the board
LVDA3: U101.9 (A7); also elsewhere on the board
LVDA4: U101.6 (A4); also elsewhere on the board
LVDA5: U101.4 (A2); also elsewhere on the board
LVDA6: U101.3 (A1); also elsewhere on the board
LVDA7: U101.2 (A0); also elsewhere on the board
LVDA8: U102.9 (A7); also elsewhere on the board
LVDA9: U102.8 (A6); also elsewhere on the board
LVDA10: U102.7 (A5); also elsewhere on the board
LVDA11: U102.6 (A4); also elsewhere on the board
LVDA12: U102.5 (A3); also elsewhere on the board
LVDA13: U102.3 (A1); also elsewhere on the board
LVDA14: U103.9 (A7); also elsewhere on the board
LVDA15: U103.8 (A6); also elsewhere on the board
LVDA16: U102.4 (A2); also elsewhere on the board
LVDA17: U103.7 (A5); also elsewhere on the board
LVDA18: U102.2 (A0); also elsewhere on the board
LVDA19: U103.5 (A3); also elsewhere on the board
LVDA20: U103.2 (A0); also elsewhere on the board
LVDA21: U104.7 (A5); also elsewhere on the board
LVDA22: U103.3 (A1); also elsewhere on the board
LVDA23: U103.6 (A4); also elsewhere on the board
LVDA24: U104.4 (A2); also elsewhere on the board
LVDA25: U103.4 (A2); also elsewhere on the board
LVDA26: U104.3 (A1); also elsewhere on the board
LVDA27: U104.9 (A7); also elsewhere on the board
LVDA28: U104.2 (A0); also elsewhere on the board
LVDA29: U104.8 (A6); also elsewhere on the board
LVDA30: U104.6 (A4); also elsewhere on the board
LVDA31: U104.5 (A3); also elsewhere on the board
LVDB0: U109.11 (B7); also elsewhere on the board
LVDB1: U109.15 (B3); also elsewhere on the board
LVDB2: U109.13 (B5); also elsewhere on the board
LVDB3: U109.12 (B6); also elsewhere on the board
LVDB4: U109.14 (B4); also elsewhere on the board
LVDB5: U109.17 (B1); also elsewhere on the board
LVDB6: U109.16 (B2); also elsewhere on the board
LVDB7: U109.18 (B0); also elsewhere on the board
LVDB8: U110.11 (B7); also elsewhere on the board
LVDB9: U110.12 (B6); also elsewhere on the board
LVDB10: U110.14 (B4); also elsewhere on the board
LVDB11: U110.13 (B5); also elsewhere on the board
LVDB12: U110.16 (B2); also elsewhere on the board
LVDB13: U110.18 (B0); also elsewhere on the board
LVDB14: U116.13 (B5); also elsewhere on the board
LVDB15: U116.12 (B6); also elsewhere on the board
LVDB16: U110.15 (B3); also elsewhere on the board
LVDB17: U116.11 (B7); also elsewhere on the board
LVDB18: U110.17 (B1); also elsewhere on the board
LVDB19: U116.15 (B3); also elsewhere on the board
LVDB20: U116.17 (B1); also elsewhere on the board
LVDB21: U117.15 (B3); also elsewhere on the board
LVDB22: U116.18 (B0); also elsewhere on the board
LVDB23: U116.16 (B2); also elsewhere on the board
LVDB24: U117.17 (B1); also elsewhere on the board
LVDB25: U116.14 (B4); also elsewhere on the board
LVDB26: U117.16 (B2); also elsewhere on the board
LVDB27: U117.12 (B6); also elsewhere on the board
LVDB28: U117.18 (B0); also elsewhere on the board
LVDB29: U117.11 (B7); also elsewhere on the board
LVDB30: U117.14 (B4); also elsewhere on the board
LVDB31: U117.13 (B5); also elsewhere on the board
R_W-3V: U101.1 (A->B), U102.1 (A->B), U103.1 (A->B), U104.1 (A->B); also elsewhere on the board
_BUFEN: U109.19 (CE), U110.19 (CE), U116.19 (CE), U117.19 (CE); also elsewhere on the board
_CPUBG: U101.19 (CE), U102.19 (CE), U103.19 (CE), U104.19 (CE), U113.1; also elsewhere on the board
_DMA: U115.1; also elsewhere on the board

Notes on the sheet:
LEVEL SHIFTING
