AmigaPCI/AmigaPCI-LBC040/KiCAD/AmigaPCI-LBC040-REV60/AmigaPCI 68040.kicad_pcb

## KiCad design KiCAD/AmigaPCI-LBC040-REV60/AmigaPCI 68040.kicad_pcb (continued)

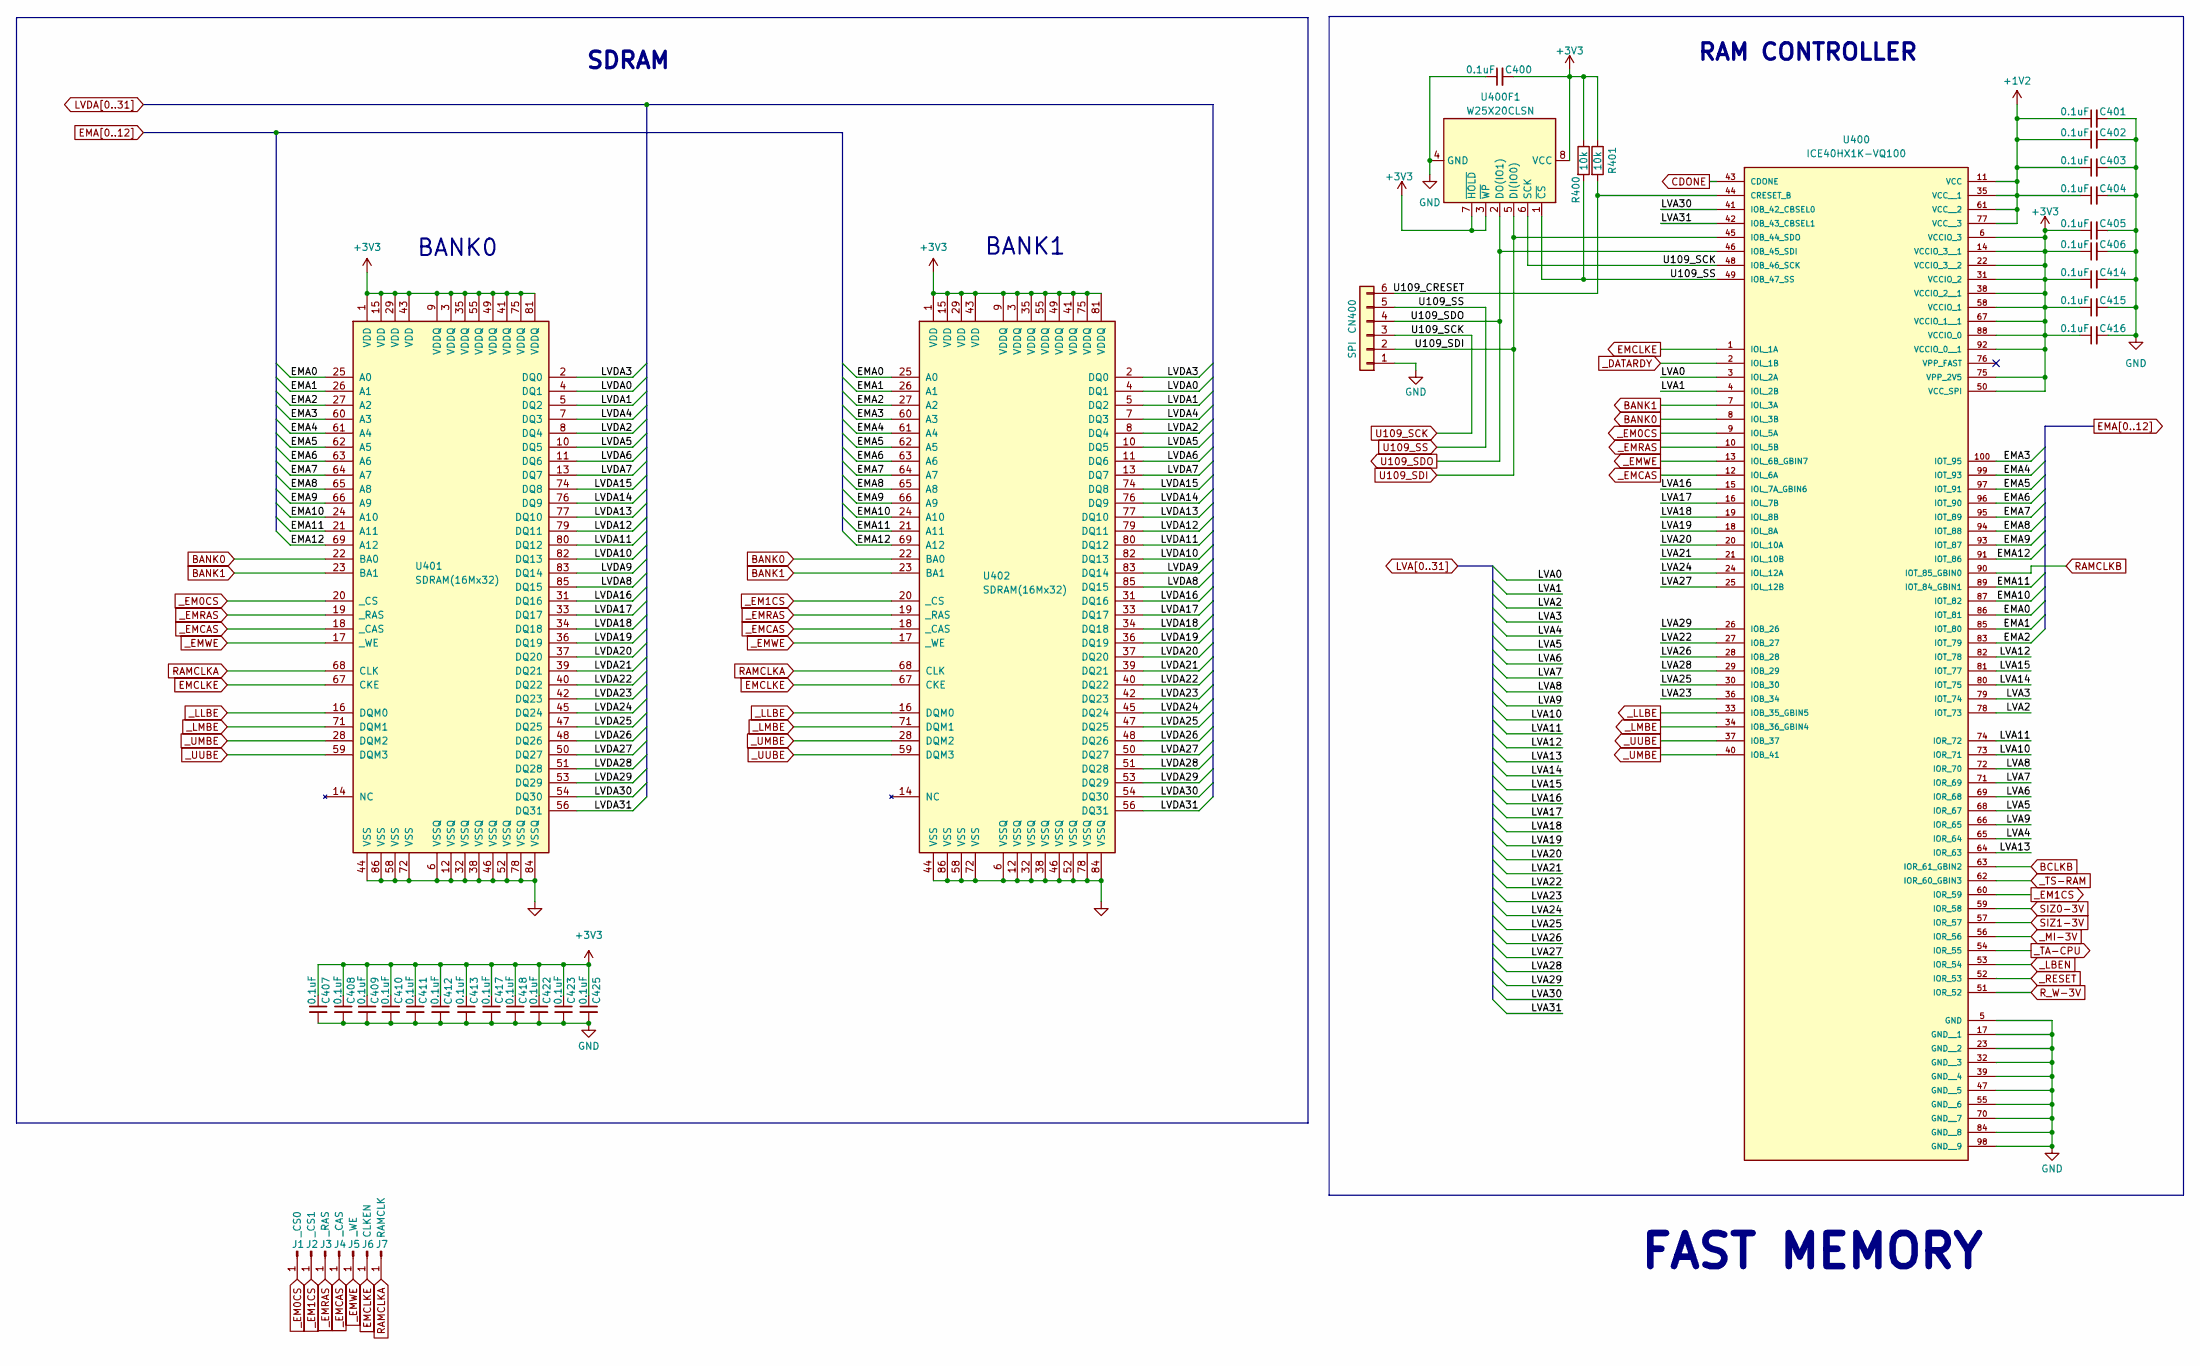
[picture p13: schematic FastMem.kicad_sch, AmigaPCI 68040 Local Bus Card]

Parts:
C400, C401, C402, C403, C404, C405, C406, C407, C408, C409, C410, C411, C412, C413, C414, C415, C416, C417, C418, C422, C423, C425: 0.1uF; C_0603_1608Metric; LCSC C14663
CN400: SPI; PinHeader_1x06_P2.54mm_Vertical; LCSC C37208
J1: _CS0; TestPoint_Pad_D1.0mm
J2: _CS1; TestPoint_Pad_D1.0mm
J3: _RAS; TestPoint_Pad_D1.0mm
J4: _CAS; TestPoint_Pad_D1.0mm
J5: _WE; TestPoint_Pad_D1.0mm
J6: CLKEN; TestPoint_Pad_D1.0mm
J7: RAMCLK; TestPoint_Pad_D1.0mm
R400, R401: 10k; R_0603_1608Metric; LCSC C25804
U400: ICE40HX1K-VQ100; LQFP-100_14x14mm_P0.5mm; PARTREV 3.4; LCSC C1519043
U400F1: W25X20CLSN; SOIC-8_3.9x4.9mm_P1.27mm; LCSC C34591
U401, U402: SDRAM(16Mx32); TSOP-II-86; LCSC C17489827

Connections:
+1V2: C401.1, C402.1, C403.1, C404.1, U400.11 (VCC), U400.35 (VCC__1), U400.61 (VCC__2), U400.77 (VCC__3); also elsewhere on the board
+3V3: C400.2, C405.1, C406.1, C407.1, C408.1, C409.1, C410.1, C411.1, C412.1, C413.1, C414.1, C415.1, C416.1, C417.1, C418.1, C422.1, C423.1, C425.1, R400.1, R401.1, U400.6 (VCCIO_3), U400.14 (VCCIO_3__1), U400.22 (VCCIO_3__2), U400.31 (VCCIO_2), U400.38 (VCCIO_2__1), U400.50 (VCC_SPI), U400.58 (VCCIO_1), U400.67 (VCCIO_1__1), U400.75 (VPP_2V5), U400.88 (VCCIO_0), U400.92 (VCCIO_0__1), U400F1.3 (~WP), U400F1.7 (~HOLD), U400F1.8 (VCC), U401.1 (VDD), U401.3 (VDDQ), U401.9 (VDDQ), U401.15 (VDD), U401.29 (VDD), U401.35 (VDDQ), U401.41 (VDDQ), U401.43 (VDD), U401.49 (VDDQ), U401.55 (VDDQ), U401.75 (VDDQ), U401.81 (VDDQ), U402.1 (VDD), U402.3 (VDDQ), U402.9 (VDDQ), U402.15 (VDD), U402.29 (VDD), U402.35 (VDDQ), U402.41 (VDDQ), U402.43 (VDD), U402.49 (VDDQ), U402.55 (VDDQ), U402.75 (VDDQ), U402.81 (VDDQ); also elsewhere on the board
/Fast Memory/U109_CRESET: CN400.6, R401.2, U400.44 (CRESET_B)
BANK0: U400.8 (IOL_3B), U401.22 (BA0), U402.22 (BA0)
BANK1: U400.7 (IOL_3A), U401.23 (BA1), U402.23 (BA1)
BCLKB: U400.63 (IOR_61_GBIN2); also elsewhere on the board
CDONE: U400.43 (CDONE); also elsewhere on the board
EMA0: U400.86 (IOT_81), U401.25 (A0), U402.25 (A0)
EMA1: U400.85 (IOT_80), U401.26 (A1), U402.26 (A1)
EMA2: U400.83 (IOT_79), U401.27 (A2), U402.27 (A2)
EMA3: U400.100 (IOT_95), U401.60 (A3), U402.60 (A3)
EMA4: U400.99 (IOT_93), U401.61 (A4), U402.61 (A4)
EMA5: U400.97 (IOT_91), U401.62 (A5), U402.62 (A5)
EMA6: U400.96 (IOT_90), U401.63 (A6), U402.63 (A6)
EMA7: U400.95 (IOT_89), U401.64 (A7), U402.64 (A7)
EMA8: U400.94 (IOT_88), U401.65 (A8), U402.65 (A8)
EMA9: U400.93 (IOT_87), U401.66 (A9), U402.66 (A9)
EMA10: U400.87 (IOT_82), U401.24 (A10), U402.24 (A10)
EMCLKE: J6.1, U400.1 (IOL_1A), U401.67 (CKE), U402.67 (CKE)
GND: C400.1, C401.2, C402.2, C403.2, C404.2, C405.2, C406.2, C407.2, C408.2, C409.2, C410.2, C411.2, C412.2, C413.2, C414.2, C415.2, C416.2, C417.2, C418.2, C422.2, C423.2, C425.2, CN400.1, U400.5 (GND), U400.17 (GND__1), U400.23 (GND__2), U400.32 (GND__3), U400.39 (GND__4), U400.47 (GND__5), U400.55 (GND__6), U400.70 (GND__7), U400.84 (GND__8), U400.98 (GND__9), U400F1.4 (GND), U401.6 (VSSQ), U401.12 (VSSQ), U401.32 (VSSQ), U401.38 (VSSQ), U401.44 (VSS), U401.46 (VSSQ), U401.52 (VSSQ), U401.58 (VSS), U401.72 (VSS), U401.78 (VSSQ), U401.84 (VSSQ), U401.86 (VSS), U402.6 (VSSQ), U402.12 (VSSQ), U402.32 (VSSQ), U402.38 (VSSQ), U402.44 (VSS), U402.46 (VSSQ), U402.52 (VSSQ), U402.58 (VSS), U402.72 (VSS), U402.78 (VSSQ), U402.84 (VSSQ), U402.86 (VSS); also elsewhere on the board
LVA0: U400.3 (IOL_2A); also elsewhere on the board
LVA1: U400.4 (IOL_2B); also elsewhere on the board
LVA2: U400.78 (IOT_73); also elsewhere on the board
LVA3: U400.79 (IOT_74); also elsewhere on the board
LVA4: U400.65 (IOR_64); also elsewhere on the board
LVA5: U400.68 (IOR_67); also elsewhere on the board
LVA6: U400.69 (IOR_68); also elsewhere on the board
LVA7: U400.71 (IOR_69); also elsewhere on the board
LVA8: U400.72 (IOR_70); also elsewhere on the board
LVA9: U400.66 (IOR_65); also elsewhere on the board
LVA10: U400.73 (IOR_71); also elsewhere on the board
LVA11: U400.74 (IOR_72); also elsewhere on the board
LVA12: U400.82 (IOT_78); also elsewhere on the board
LVA13: U400.64 (IOR_63); also elsewhere on the board
LVA14: U400.80 (IOT_75); also elsewhere on the board
LVA15: U400.81 (IOT_77); also elsewhere on the board
LVA16: U400.15 (IOL_7A_GBIN6); also elsewhere on the board
LVA17: U400.16 (IOL_7B); also elsewhere on the board
LVA18: U400.19 (IOL_8B); also elsewhere on the board
LVA19: U400.18 (IOL_8A); also elsewhere on the board
LVA20: U400.20 (IOL_10A); also elsewhere on the board
LVA21: U400.21 (IOL_10B); also elsewhere on the board
LVA22: U400.27 (IOB_27); also elsewhere on the board
LVA23: U400.36 (IOB_34); also elsewhere on the board
LVA24: U400.24 (IOL_12A); also elsewhere on the board
LVA25: U400.30 (IOB_30); also elsewhere on the board
LVA26: U400.28 (IOB_28); also elsewhere on the board
LVA27: U400.25 (IOL_12B); also elsewhere on the board
LVA28: U400.29 (IOB_29); also elsewhere on the board
LVA29: U400.26 (IOB_26); also elsewhere on the board
LVA30: U400.41 (IOB_42_CBSEL0); also elsewhere on the board
LVA31: U400.42 (IOB_43_CBSEL1); also elsewhere on the board
LVDA0: U401.4 (DQ1), U402.4 (DQ1); also elsewhere on the board
LVDA1: U401.5 (DQ2), U402.5 (DQ2); also elsewhere on the board
LVDA2: U401.8 (DQ4), U402.8 (DQ4); also elsewhere on the board
LVDA3: U401.2 (DQ0), U402.2 (DQ0); also elsewhere on the board
LVDA4: U401.7 (DQ3), U402.7 (DQ3); also elsewhere on the board
LVDA5: U401.10 (DQ5), U402.10 (DQ5); also elsewhere on the board
LVDA6: U401.11 (DQ6), U402.11 (DQ6); also elsewhere on the board
LVDA7: U401.13 (DQ7), U402.13 (DQ7); also elsewhere on the board
LVDA8: U401.85 (DQ15), U402.85 (DQ15); also elsewhere on the board
LVDA9: U401.83 (DQ14), U402.83 (DQ14); also elsewhere on the board
LVDA10: U401.82 (DQ13), U402.82 (DQ13); also elsewhere on the board
LVDA11: U401.80 (DQ12), U402.80 (DQ12); also elsewhere on the board
LVDA12: U401.79 (DQ11), U402.79 (DQ11); also elsewhere on the board
LVDA13: U401.77 (DQ10), U402.77 (DQ10); also elsewhere on the board
LVDA14: U401.76 (DQ9), U402.76 (DQ9); also elsewhere on the board
LVDA15: U401.74 (DQ8), U402.74 (DQ8); also elsewhere on the board
LVDA16: U401.31 (DQ16), U402.31 (DQ16); also elsewhere on the board
LVDA17: U401.33 (DQ17), U402.33 (DQ17); also elsewhere on the board
LVDA18: U401.34 (DQ18), U402.34 (DQ18); also elsewhere on the board
LVDA19: U401.36 (DQ19), U402.36 (DQ19); also elsewhere on the board
LVDA20: U401.37 (DQ20), U402.37 (DQ20); also elsewhere on the board
LVDA21: U401.39 (DQ21), U402.39 (DQ21); also elsewhere on the board
LVDA22: U401.40 (DQ22), U402.40 (DQ22); also elsewhere on the board
LVDA23: U401.42 (DQ23), U402.42 (DQ23); also elsewhere on the board
LVDA24: U401.45 (DQ24), U402.45 (DQ24); also elsewhere on the board
LVDA25: U401.47 (DQ25), U402.47 (DQ25); also elsewhere on the board
LVDA26: U401.48 (DQ26), U402.48 (DQ26); also elsewhere on the board
LVDA27: U401.50 (DQ27), U402.50 (DQ27); also elsewhere on the board
LVDA28: U401.51 (DQ28), U402.51 (DQ28); also elsewhere on the board
LVDA29: U401.53 (DQ29), U402.53 (DQ29); also elsewhere on the board
LVDA30: U401.54 (DQ30), U402.54 (DQ30); also elsewhere on the board
LVDA31: U401.56 (DQ31), U402.56 (DQ31); also elsewhere on the board
RAMCLKA: J7.1, U401.68 (CLK), U402.68 (CLK); also elsewhere on the board
RAMCLKB: U400.90 (IOT_85_GBIN0); also elsewhere on the board
R_W-3V: U400.51 (IOR_52); also elsewhere on the board
SIZ0-3V: U400.59 (IOR_58); also elsewhere on the board
SIZ1-3V: U400.57 (IOR_57); also elsewhere on the board
U109_SCK: CN400.3, U400.48 (IOB_46_SCK), U400F1.6 (SCK); also elsewhere on the board
U109_SDI: CN400.2, U400.45 (IOB_44_SDO), U400F1.5 (DI(IO0)); also elsewhere on the board
U109_SDO: CN400.4, U400.46 (IOB_45_SDI), U400F1.2 (DO(IO1)); also elsewhere on the board
U109_SS: CN400.5, R400.2, U400.49 (IOB_47_SS), U400F1.1 (~CS); also elsewhere on the board
_DATARDY: U400.2 (IOL_1B); also elsewhere on the board
_EM0CS: J1.1, U400.9 (IOL_5A), U401.20 (_CS)
_EM1CS: J2.1, U400.60 (IOR_59), U402.20 (_CS)
_EMCAS: J4.1, U400.12 (IOL_6A), U401.18 (_CAS), U402.18 (_CAS)
_EMRAS: J3.1, U400.10 (IOL_5B), U401.19 (_RAS), U402.19 (_RAS)
_EMWE: J5.1, U400.13 (IOL_6B_GBIN7), U401.17 (_WE), U402.17 (_WE)
_LBEN: U400.53 (IOR_54); also elsewhere on the board
_LLBE: U400.33 (IOB_35_GBIN5), U401.16 (DQM0), U402.16 (DQM0)
_LMBE: U400.34 (IOB_36_GBIN4), U401.71 (DQM1), U402.71 (DQM1)
_MI-3V: U400.56 (IOR_56); also elsewhere on the board
_RESET: U400.52 (IOR_53); also elsewhere on the board
_TA-CPU: U400.54 (IOR_55); also elsewhere on the board
_TS-RAM: U400.62 (IOR_60_GBIN3); also elsewhere on the board
_UMBE: U400.40 (IOB_41), U401.28 (DQM2), U402.28 (DQM2)
_UUBE: U400.37 (IOB_37), U401.59 (DQM3), U402.59 (DQM3)

Notes on the sheet:
RAM CONTROLLER
FAST MEMORY
BANK0
SDRAM
BANK1

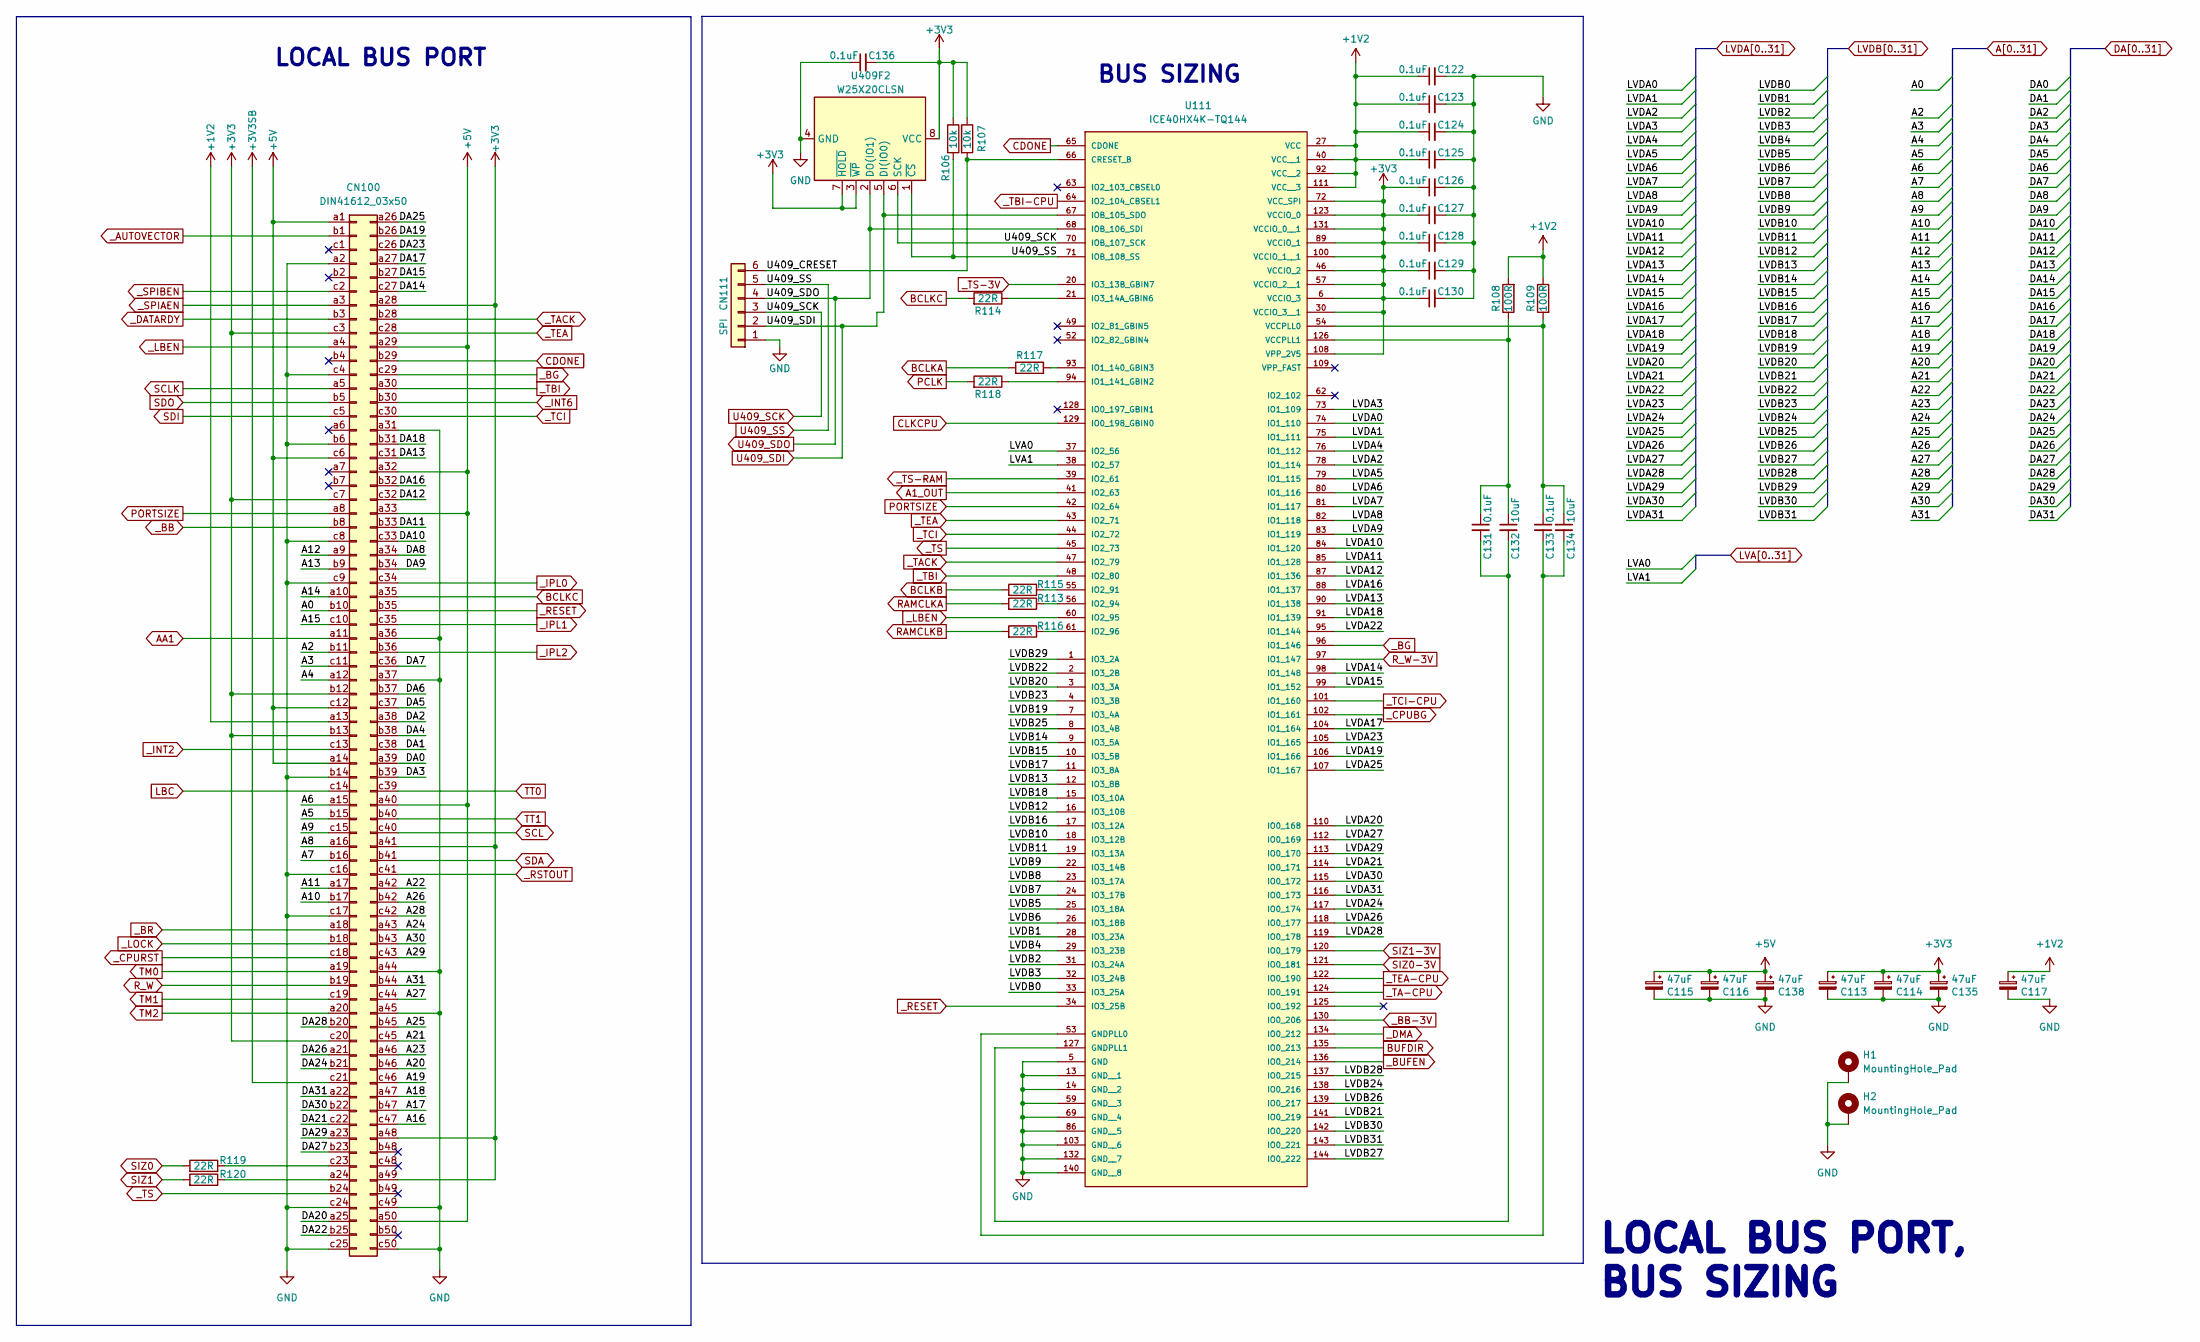
[picture p14: schematic CardConnector.kicad_sch, AmigaPCI 68040 Local Bus Card]

Parts:
C113, C114, C115, C116, C117, C135, C138: 47uF; CP_Radial_D5.0mm_P2.00mm; LCSC C88724
C122, C123, C124, C125, C126, C127, C128, C129, C130, C131, C133, C136: 0.1uF; C_0603_1608Metric; LCSC C14663
C132, C134: 10uF; C_0603_1608Metric; LCSC C96446
CN100: DIN41612_03x50; DIN41612_C_3x50_Male_Vertical_THT; LCSC C3654550
CN111: SPI; PinHeader_1x06_P2.54mm_Vertical; LCSC C37208
H1, H2: MountingHole_Pad; MountingHole_3.5mm_Pad
R106, R107: 10k; R_0603_1608Metric; LCSC C25804
R108, R109: 100R; R_0603_1608Metric; LCSC C22775
R113, R114, R115, R116, R117, R118, R119, R120: 22R; R_0603_1608Metric; LCSC C23345
U111: ICE40HX4K-TQ144; LQFP-144_20x20mm_P0.5mm; LCSC C1521989
U409F2: W25X20CLSN; SOIC-8_3.9x4.9mm_P1.27mm; LCSC C34591

Connections:
+1V2: C117.1, C122.1, C123.1, C124.1, C125.1, CN100.a13, R108.2, R109.1, U111.27 (VCC), U111.40 (VCC__1), U111.92 (VCC__2), U111.111 (VCC__3); also elsewhere on the board
+3V3: C113.1, C114.1, C126.1, C127.1, C128.1, C129.1, C130.1, C135.1, C136.2, CN100.a28, CN100.a41, CN100.a48, CN100.a49, CN100.b12, CN100.b13, CN100.c3, CN100.c7, CN100.c20, R106.1, R107.1, U111.6 (VCCIO_3), U111.30 (VCCIO_3__1), U111.46 (VCCIO_2), U111.57 (VCCIO_2__1), U111.72 (VCC_SPI), U111.89 (VCCIO_1), U111.100 (VCCIO_1__1), U111.108 (VPP_2V5), U111.123 (VCCIO_0), U111.131 (VCCIO_0__1), U409F2.3 (~WP), U409F2.7 (~HOLD), U409F2.8 (VCC); also elsewhere on the board
+3V3SB: CN100.c21
+5V: C115.1, C116.1, C138.1, CN100.a1, CN100.a14, CN100.a29, CN100.a32, CN100.a33, CN100.a40, CN100.a50, CN100.c6, CN100.c12; also elsewhere on the board
/Card Connector/U409_CRESET: CN111.6, R107.2, U111.66 (CRESET_B)
A0: CN100.b10; also elsewhere on the board
A1_OUT: U111.41 (IO2_63); also elsewhere on the board
A2: CN100.b11; also elsewhere on the board
A3: CN100.c11; also elsewhere on the board
A4: CN100.a12; also elsewhere on the board
A5: CN100.b15; also elsewhere on the board
A6: CN100.a15; also elsewhere on the board
A7: CN100.b16; also elsewhere on the board
A8: CN100.a16; also elsewhere on the board
A9: CN100.c15; also elsewhere on the board
A10: CN100.b17; also elsewhere on the board
A11: CN100.a17; also elsewhere on the board
A12: CN100.a9; also elsewhere on the board
A13: CN100.b9; also elsewhere on the board
A14: CN100.a10; also elsewhere on the board
A15: CN100.c10; also elsewhere on the board
A16: CN100.c47; also elsewhere on the board
A17: CN100.b47; also elsewhere on the board
A18: CN100.a47; also elsewhere on the board
A19: CN100.c46; also elsewhere on the board
A20: CN100.b46; also elsewhere on the board
A21: CN100.c45; also elsewhere on the board
A22: CN100.a42; also elsewhere on the board
A23: CN100.a46; also elsewhere on the board
A24: CN100.a43; also elsewhere on the board
A25: CN100.b45; also elsewhere on the board
A26: CN100.b42; also elsewhere on the board
A27: CN100.c44; also elsewhere on the board
A28: CN100.c42; also elsewhere on the board
A29: CN100.c43; also elsewhere on the board
A30: CN100.b43; also elsewhere on the board
A31: CN100.b44; also elsewhere on the board
AA1: CN100.a11; also elsewhere on the board
BCLKA: R117.2; also elsewhere on the board
BCLKB: R115.2; also elsewhere on the board
BCLKC: CN100.a35, R114.2
BUFDIR: U111.135 (IO0_213); also elsewhere on the board
CDONE: CN100.b29, U111.65 (CDONE); also elsewhere on the board
CLKCPU: U111.129 (IO0_198_GBIN0); also elsewhere on the board
DA0: CN100.a39; also elsewhere on the board
DA1: CN100.c38; also elsewhere on the board
DA2: CN100.a38; also elsewhere on the board
DA3: CN100.b39; also elsewhere on the board
DA4: CN100.b38; also elsewhere on the board
DA5: CN100.c37; also elsewhere on the board
DA6: CN100.b37; also elsewhere on the board
DA7: CN100.c36; also elsewhere on the board
DA8: CN100.a34; also elsewhere on the board
DA9: CN100.b34; also elsewhere on the board
DA10: CN100.c33; also elsewhere on the board
DA11: CN100.b33; also elsewhere on the board
DA12: CN100.c32; also elsewhere on the board
DA13: CN100.c31; also elsewhere on the board
DA14: CN100.c27; also elsewhere on the board
DA15: CN100.b27; also elsewhere on the board
DA16: CN100.b32; also elsewhere on the board
DA17: CN100.a27; also elsewhere on the board
DA18: CN100.b31; also elsewhere on the board
DA19: CN100.b26; also elsewhere on the board
DA20: CN100.a25; also elsewhere on the board
DA21: CN100.c22; also elsewhere on the board
DA22: CN100.b25; also elsewhere on the board
DA23: CN100.c26; also elsewhere on the board
DA24: CN100.b21; also elsewhere on the board
DA25: CN100.a26; also elsewhere on the board
DA26: CN100.a21; also elsewhere on the board
DA27: CN100.b23; also elsewhere on the board
DA28: CN100.b20; also elsewhere on the board
DA29: CN100.a23; also elsewhere on the board
DA30: CN100.b22; also elsewhere on the board
DA31: CN100.a22; also elsewhere on the board
GND: C113.2, C114.2, C115.2, C116.2, C117.2, C122.2, C123.2, C124.2, C125.2, C126.2, C127.2, C128.2, C129.2, C130.2, C135.2, C136.1, C138.2, CN100.a2, CN100.a31, CN100.a36, CN100.a37, CN100.a44, CN100.a45, CN100.b6, CN100.b14, CN100.c4, CN100.c8, CN100.c9, CN100.c16, CN100.c17, CN100.c24, CN100.c25, CN100.c49, CN100.c50, CN111.1, H1.1, H2.1, U111.5 (GND), U111.13 (GND__1), U111.14 (GND__2), U111.59 (GND__3), U111.69 (GND__4), U111.86 (GND__5), U111.103 (GND__6), U111.132 (GND__7), U111.140 (GND__8), U409F2.4 (GND); also elsewhere on the board
LBC: CN100.c14
LVA0: U111.37 (IO2_56); also elsewhere on the board
LVA1: U111.38 (IO2_57); also elsewhere on the board
LVDA0: U111.74 (IO1_110); also elsewhere on the board
LVDA1: U111.75 (IO1_111); also elsewhere on the board
LVDA2: U111.78 (IO1_114); also elsewhere on the board
LVDA3: U111.73 (IO1_109); also elsewhere on the board
LVDA4: U111.76 (IO1_112); also elsewhere on the board
LVDA5: U111.79 (IO1_115); also elsewhere on the board
LVDA6: U111.80 (IO1_116); also elsewhere on the board
LVDA7: U111.81 (IO1_117); also elsewhere on the board
LVDA8: U111.82 (IO1_118); also elsewhere on the board
LVDA9: U111.83 (IO1_119); also elsewhere on the board
LVDA10: U111.84 (IO1_120); also elsewhere on the board
LVDA11: U111.85 (IO1_128); also elsewhere on the board
LVDA12: U111.87 (IO1_136); also elsewhere on the board
LVDA13: U111.90 (IO1_138); also elsewhere on the board
LVDA14: U111.98 (IO1_148); also elsewhere on the board
LVDA15: U111.99 (IO1_152); also elsewhere on the board
LVDA16: U111.88 (IO1_137); also elsewhere on the board
LVDA17: U111.104 (IO1_164); also elsewhere on the board
LVDA18: U111.91 (IO1_139); also elsewhere on the board
LVDA19: U111.106 (IO1_166); also elsewhere on the board
LVDA20: U111.110 (IO0_168); also elsewhere on the board
LVDA21: U111.114 (IO0_171); also elsewhere on the board
LVDA22: U111.95 (IO1_144); also elsewhere on the board
LVDA23: U111.105 (IO1_165); also elsewhere on the board
LVDA24: U111.117 (IO0_174); also elsewhere on the board
LVDA25: U111.107 (IO1_167); also elsewhere on the board
LVDA26: U111.118 (IO0_177); also elsewhere on the board
LVDA27: U111.112 (IO0_169); also elsewhere on the board
LVDA28: U111.119 (IO0_178); also elsewhere on the board
LVDA29: U111.113 (IO0_170); also elsewhere on the board
LVDA30: U111.115 (IO0_172); also elsewhere on the board
LVDA31: U111.116 (IO0_173); also elsewhere on the board
LVDB0: U111.33 (IO3_25A); also elsewhere on the board
LVDB1: U111.28 (IO3_23A); also elsewhere on the board
LVDB2: U111.31 (IO3_24A); also elsewhere on the board
LVDB3: U111.32 (IO3_24B); also elsewhere on the board
LVDB4: U111.29 (IO3_23B); also elsewhere on the board
LVDB5: U111.25 (IO3_18A); also elsewhere on the board
LVDB6: U111.26 (IO3_18B); also elsewhere on the board
LVDB7: U111.24 (IO3_17B); also elsewhere on the board
LVDB8: U111.23 (IO3_17A); also elsewhere on the board
LVDB9: U111.22 (IO3_14B); also elsewhere on the board
LVDB10: U111.18 (IO3_12B); also elsewhere on the board
LVDB11: U111.19 (IO3_13A); also elsewhere on the board
LVDB12: U111.16 (IO3_10B); also elsewhere on the board
LVDB13: U111.12 (IO3_8B); also elsewhere on the board
LVDB14: U111.9 (IO3_5A); also elsewhere on the board
LVDB15: U111.10 (IO3_5B); also elsewhere on the board
LVDB16: U111.17 (IO3_12A); also elsewhere on the board
LVDB17: U111.11 (IO3_8A); also elsewhere on the board
LVDB18: U111.15 (IO3_10A); also elsewhere on the board
LVDB19: U111.7 (IO3_4A); also elsewhere on the board
LVDB20: U111.3 (IO3_3A); also elsewhere on the board
LVDB21: U111.141 (IO0_219); also elsewhere on the board
LVDB22: U111.2 (IO3_2B); also elsewhere on the board
LVDB23: U111.4 (IO3_3B); also elsewhere on the board
LVDB24: U111.138 (IO0_216); also elsewhere on the board
LVDB25: U111.8 (IO3_4B); also elsewhere on the board
LVDB26: U111.139 (IO0_217); also elsewhere on the board
LVDB27: U111.144 (IO0_222); also elsewhere on the board
LVDB28: U111.137 (IO0_215); also elsewhere on the board
LVDB29: U111.1 (IO3_2A); also elsewhere on the board
LVDB30: U111.142 (IO0_220); also elsewhere on the board
LVDB31: U111.143 (IO0_221); also elsewhere on the board
unnamed: CN100.a24, R120.1
unnamed: CN100.c23, R119.1
unnamed: C133.2, C134.2, U111.53 (GNDPLL0)
unnamed: C131.2, C132.2, U111.127 (GNDPLL1)
unnamed: R117.1, U111.93 (IO1_140_GBIN3)
unnamed: R118.1, U111.94 (IO1_141_GBIN2)
unnamed: R115.1, U111.55 (IO2_91)
unnamed: R113.1, U111.56 (IO2_94)
unnamed: R116.1, U111.61 (IO2_96)
unnamed: R114.1, U111.21 (IO3_14A_GBIN6)
unnamed: C133.1, C134.1, R109.2, U111.54 (VCCPLL0)
unnamed: C131.1, C132.1, R108.1, U111.126 (VCCPLL1)
PCLK: R118.2; also elsewhere on the board
PORTSIZE: CN100.a8, U111.42 (IO2_64)
RAMCLKA: R113.2; also elsewhere on the board
RAMCLKB: R116.2; also elsewhere on the board
R_W: CN100.b19; also elsewhere on the board
R_W-3V: U111.97 (IO1_147); also elsewhere on the board
SCL: CN100.c40
SCLK: CN100.a5; also elsewhere on the board
SDA: CN100.b41
SDI: CN100.c5; also elsewhere on the board
SDO: CN100.b5; also elsewhere on the board
SIZ0: R119.2; also elsewhere on the board
SIZ0-3V: U111.121 (IO0_181); also elsewhere on the board
SIZ1: R120.2; also elsewhere on the board
SIZ1-3V: U111.120 (IO0_179); also elsewhere on the board
TM0: CN100.a19; also elsewhere on the board
TM1: CN100.c19; also elsewhere on the board
TM2: CN100.a20; also elsewhere on the board
TT0: CN100.c39; also elsewhere on the board
TT1: CN100.b40; also elsewhere on the board
U409_SCK: CN111.3, U111.70 (IOB_107_SCK), U409F2.6 (SCK); also elsewhere on the board
U409_SDI: CN111.2, U111.67 (IOB_105_SDO), U409F2.5 (DI(IO0)); also elsewhere on the board
U409_SDO: CN111.4, U111.68 (IOB_106_SDI), U409F2.2 (DO(IO1)); also elsewhere on the board
U409_SS: CN111.5, R106.2, U111.71 (IOB_108_SS), U409F2.1 (~CS); also elsewhere on the board
_AUTOVECTOR: CN100.b1; also elsewhere on the board
_BB: CN100.b8; also elsewhere on the board
_BB-3V: U111.130 (IO0_206); also elsewhere on the board
_BG: CN100.c29, U111.96 (IO1_146); also elsewhere on the board
_BR: CN100.a18; also elsewhere on the board
_BUFEN: U111.136 (IO0_214); also elsewhere on the board
_CPUBG: U111.102 (IO1_161); also elsewhere on the board
_CPURST: CN100.c18; also elsewhere on the board
_DATARDY: CN100.b3; also elsewhere on the board
_DMA: U111.134 (IO0_212); also elsewhere on the board
_INT2: CN100.c13
_INT6: CN100.b30
_IPL0: CN100.c34; also elsewhere on the board
_IPL1: CN100.c35; also elsewhere on the board
_IPL2: CN100.b36; also elsewhere on the board
_LBEN: CN100.a4, U111.60 (IO2_95); also elsewhere on the board
_LOCK: CN100.b18; also elsewhere on the board
_RESET: CN100.b35, U111.34 (IO3_25B); also elsewhere on the board
_RSTOUT: CN100.c41; also elsewhere on the board
_SPIAEN: CN100.a3; also elsewhere on the board
_SPIBEN: CN100.c2; also elsewhere on the board
_TA-CPU: U111.124 (IO0_191); also elsewhere on the board
_TACK: CN100.b28, U111.47 (IO2_79)
_TBI: CN100.a30, U111.48 (IO2_80)
_TBI-CPU: U111.64 (IO2_104_CBSEL1); also elsewhere on the board
_TCI: CN100.c30, U111.44 (IO2_72)
_TCI-CPU: U111.101 (IO1_160); also elsewhere on the board
_TEA: CN100.c28, U111.43 (IO2_71)
_TEA-CPU: U111.122 (IO0_190); also elsewhere on the board
_TS: CN100.b24, U111.45 (IO2_73)
_TS-3V: U111.20 (IO3_13B_GBIN7); also elsewhere on the board
_TS-RAM: U111.39 (IO2_61); also elsewhere on the board

Notes on the sheet:
BUS SIZING
LOCAL BUS PORT, BUS SIZING
LOCAL BUS PORT

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
