AmigaPCI/AmigaPCI-LBC040/KiCAD/AmigaPCI-LBC040-REV60/AmigaPCI 68040.kicad_pcb

## KiCad design KiCAD/AmigaPCI-LBC040-REV60/AmigaPCI 68040.kicad_pcb (continued)

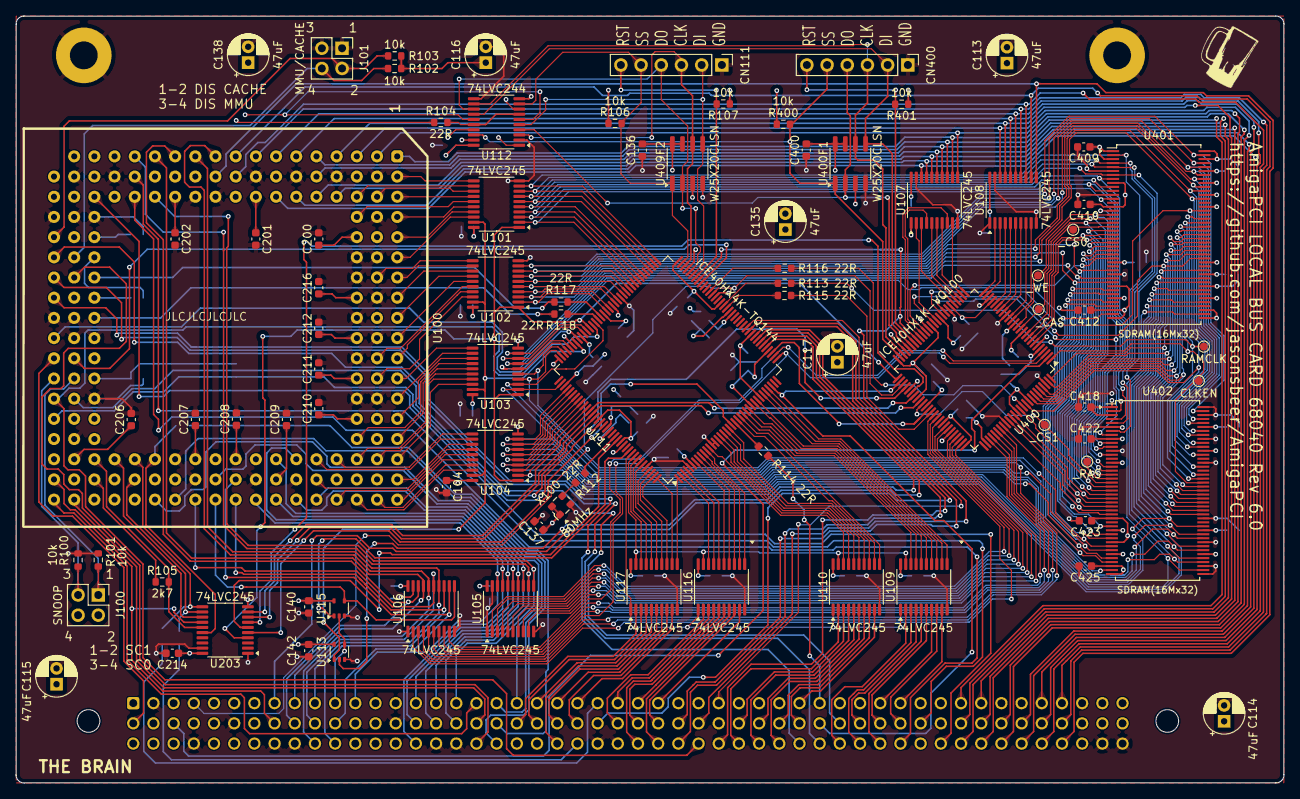
[picture p15: board AmigaPCI 68040.kicad_pcb from above]

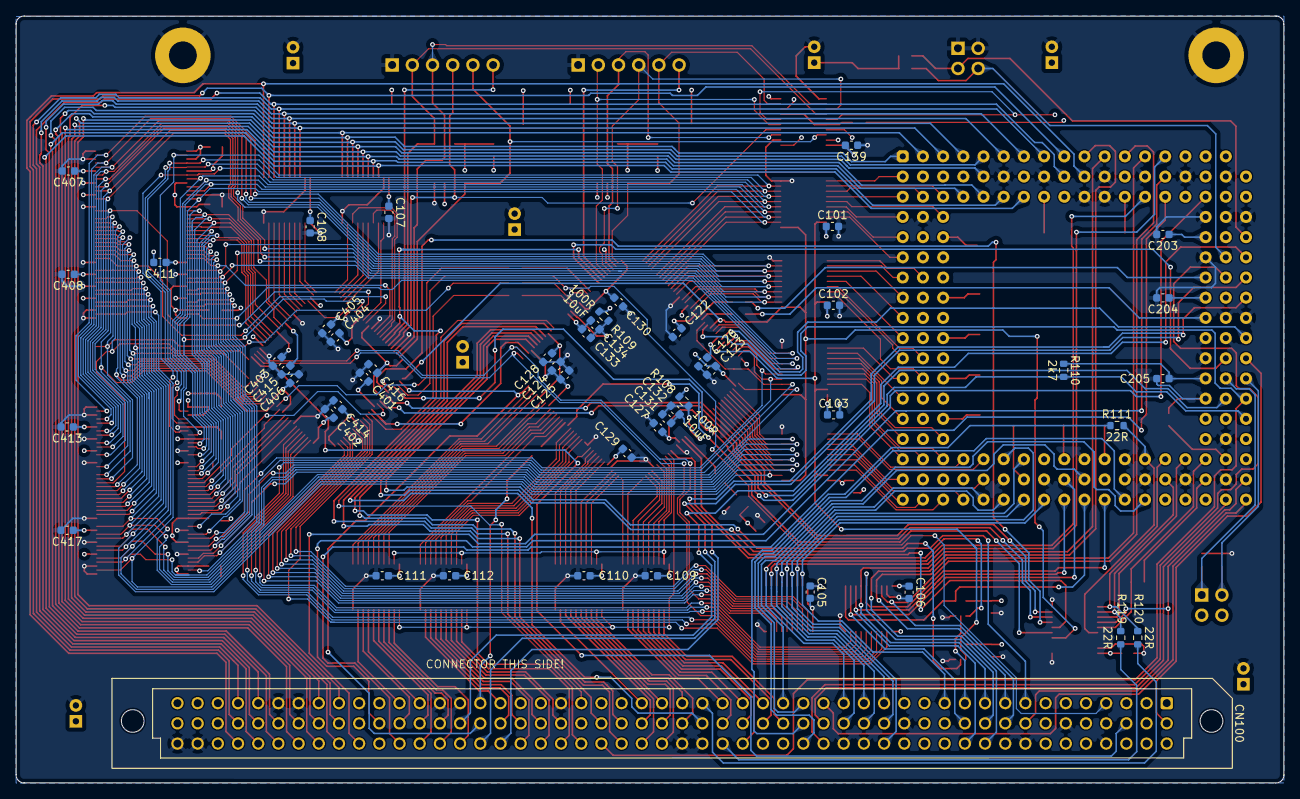
[picture p16: board AmigaPCI 68040.kicad_pcb from below]

Board: 6 copper layers, 159.5 x 96.5 mm, 135 parts (49 on the bottom side), 309 nets.

Other parts of the board:
C137, C216: 0.1uF; C_0603_1608Metric
R112: 22R; R_0603_1608Metric
U100: MC68040; PGA179
X100: 80MHz; Oscillator_SMD_ECS_2520MV-xxx-xx-4Pin_2.5x2.0mm

Their connections:
+3V3: C137.1, X100.1 (EN), X100.4 (V+); also elsewhere on the board
+5V: C216.1, U100.23 (Vcc), U100.27 (Vcc), U100.32 (Vcc), U100.38 (Vcc), U100.41 (Vcc), U100.44 (Vcc), U100.46 (Vcc), U100.48 (Vcc), U100.50 (Vcc), U100.53 (Vcc), U100.74 (Vcc), U100.77 (Vcc), U100.81 (Vcc), U100.82 (Vcc), U100.87 (Vcc), U100.88 (Vcc), U100.100 (Vcc), U100.104 (Vcc), U100.105 (Vcc), U100.107 (Vcc), U100.128 (Vcc), U100.131 (Vcc), U100.134 (Vcc), U100.138 (Vcc), U100.143 (Vcc), U100.152 (Vcc), U100.160 (Vcc); also elsewhere on the board
/CPU/SC0: U100.173 (SC0); also elsewhere on the board
/CPU/SC1: U100.156 (SC1); also elsewhere on the board
/CPU/_CDIS: U100.166 (_CDIS); also elsewhere on the board
/CPU/_MDIS: U100.150 (_MDIS); also elsewhere on the board
A0: U100.102 (A0); also elsewhere on the board
A1: U100.96 (A1); also elsewhere on the board
A2: U100.89 (A2); also elsewhere on the board
A3: U100.90 (A3); also elsewhere on the board
A4: U100.84 (A4); also elsewhere on the board
A5: U100.78 (A5); also elsewhere on the board
A6: U100.76 (A6); also elsewhere on the board
A7: U100.72 (A7); also elsewhere on the board
A8: U100.66 (A8); also elsewhere on the board
A9: U100.70 (A9); also elsewhere on the board
A10: U100.115 (A10); also elsewhere on the board
A11: U100.111 (A11); also elsewhere on the board
A12: U100.109 (A12); also elsewhere on the board
A13: U100.103 (A13); also elsewhere on the board
A14: U100.97 (A14); also elsewhere on the board
A15: U100.91 (A15); also elsewhere on the board
A16: U100.92 (A16); also elsewhere on the board
A17: U100.85 (A17); also elsewhere on the board
A18: U100.79 (A18); also elsewhere on the board
A19: U100.86 (A19); also elsewhere on the board
A20: U100.73 (A20); also elsewhere on the board
A21: U100.67 (A21); also elsewhere on the board
A22: U100.61 (A22); also elsewhere on the board
A23: U100.75 (A23); also elsewhere on the board
A24: U100.55 (A24); also elsewhere on the board
A25: U100.69 (A25); also elsewhere on the board
A26: U100.62 (A26); also elsewhere on the board
A27: U100.37 (A27); also elsewhere on the board
A28: U100.63 (A28); also elsewhere on the board
A29: U100.19 (A29); also elsewhere on the board
A30: U100.57 (A30); also elsewhere on the board
A31: U100.1 (A31); also elsewhere on the board
BCLKA: U100.133 (BCLK); also elsewhere on the board
CLKCPU: R112.1; also elsewhere on the board
D0: U100.39 (D0); also elsewhere on the board
D1: U100.21 (D1); also elsewhere on the board
D2: U100.40 (D2); also elsewhere on the board
D3: U100.2 (D3); also elsewhere on the board
D4: U100.3 (D4); also elsewhere on the board
D5: U100.4 (D5); also elsewhere on the board
D6: U100.5 (D6); also elsewhere on the board
D7: U100.6 (D7); also elsewhere on the board
D8: U100.25 (D8); also elsewhere on the board
D9: U100.7 (D9); also elsewhere on the board
D10: U100.8 (D10); also elsewhere on the board
D11: U100.9 (D11); also elsewhere on the board
D12: U100.10 (D12); also elsewhere on the board
D13: U100.11 (D13); also elsewhere on the board
D14: U100.12 (D14); also elsewhere on the board
D15: U100.13 (D15); also elsewhere on the board
D16: U100.29 (D16); also elsewhere on the board
D17: U100.14 (D17); also elsewhere on the board
D18: U100.30 (D18); also elsewhere on the board
D19: U100.15 (D19); also elsewhere on the board
D20: U100.16 (D20); also elsewhere on the board
D21: U100.17 (D21); also elsewhere on the board
D22: U100.34 (D22); also elsewhere on the board
D23: U100.51 (D23); also elsewhere on the board
D24: U100.18 (D24); also elsewhere on the board
D25: U100.52 (D25); also elsewhere on the board
D26: U100.36 (D26); also elsewhere on the board
D27: U100.58 (D27); also elsewhere on the board
D28: U100.54 (D28); also elsewhere on the board
D29: U100.64 (D29); also elsewhere on the board
D30: U100.65 (D30); also elsewhere on the board
D31: U100.60 (D31); also elsewhere on the board
GND: C137.2, C216.2, U100.20 (GND), U100.22 (GND), U100.24 (GND), U100.26 (GND), U100.28 (GND), U100.31 (GND), U100.33 (GND), U100.35 (GND), U100.42 (GND), U100.43 (GND), U100.45 (GND), U100.47 (GND), U100.49 (GND), U100.56 (GND), U100.59 (GND), U100.68 (GND), U100.71 (GND), U100.80 (GND), U100.83 (GND), U100.93 (GND), U100.94 (GND), U100.98 (GND), U100.99 (GND), U100.101 (GND), U100.106 (GND), U100.110 (GND), U100.113 (GND), U100.122 (GND), U100.125 (GND), U100.130 (GND), U100.132 (GND), U100.136 (GND), U100.137 (GND), U100.139 (GND), U100.146 (GND), U100.148 (TCK), U100.153 (GND), U100.154 (GND), U100.159 (GND), U100.161 (GND), U100.165 (GND), U100.170 (DLE), X100.2 (GND); also elsewhere on the board
unnamed: R112.2, X100.3 (OUT)
PCLK: U100.135 (PCLK); also elsewhere on the board
R_W-CPU: U100.112 (R_W); also elsewhere on the board
SIZ0: U100.119 (SIZ0); also elsewhere on the board
SIZ1: U100.118 (SIZ1); also elsewhere on the board
TM0: U100.114 (TM0); also elsewhere on the board
TM1: U100.108 (TM1); also elsewhere on the board
TM2: U100.95 (TM2); also elsewhere on the board
TT0: U100.117 (TT0); also elsewhere on the board
TT1: U100.116 (TT1); also elsewhere on the board
_AUTOVECTOR: U100.172 (_AVEC); also elsewhere on the board
_BB: U100.178 (_BB); also elsewhere on the board
_BG: U100.174 (_BG); also elsewhere on the board
_BR: U100.179 (_BR); also elsewhere on the board
_CPURST: U100.151 (_RSTI); also elsewhere on the board
_IPL0: U100.169 (_IPL0); also elsewhere on the board
_IPL1: U100.168 (_IPL1); also elsewhere on the board
_IPL2: U100.167 (_IPL2); also elsewhere on the board
_LOCK: U100.162 (_LOCK); also elsewhere on the board
_MI: U100.124 (_MI); also elsewhere on the board
_RSTOUT: U100.129 (_RSTO); also elsewhere on the board
_TA-CPU: U100.175 (_TA); also elsewhere on the board
_TBI-CPU: U100.155 (_TBI); also elsewhere on the board
_TCI-CPU: U100.171 (_TCI); also elsewhere on the board
_TEA-CPU: U100.157 (_TEA); also elsewhere on the board
_TS-CPU: U100.142 (_TS); also elsewhere on the board
