AmigaPCI/AmigaPCI-LBC040/(commit log)

2026-02-13 U111 daily. 12-FEB-2026
    Fix assertion of _TS on the CPU side of the FPGA during DMA cycles.
2026-06-23 Push hardware revision 6.0
    [5145154-4.step, 5650910-5.stp, AmigaPCI 68040 JLCPCB BOM ALL PARTS.csv, AmigaPCI 68040 JLCPCB BOM SMT.csv, AmigaPCI 68040 REV60 BOM LCSC.csv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]
2026-07-15 U111: Fix inverted _TS signal on DMA.
